NicolasU-N/PeltierController/Deliverables_PeltierPWMControlPCB/Deliverables/Images/6.jpg

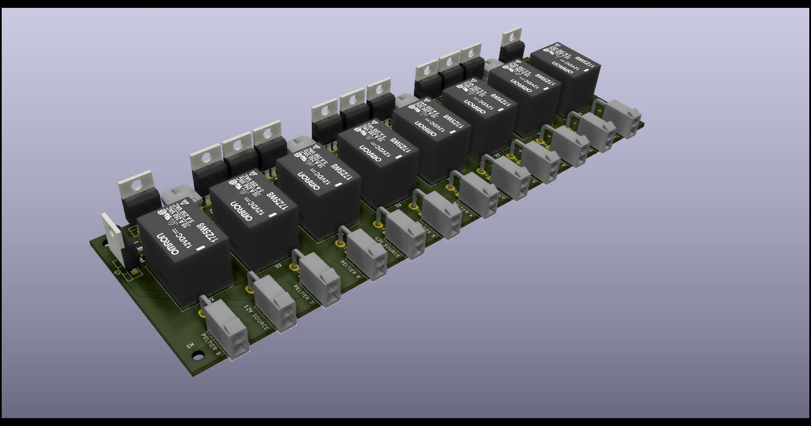
Deliverables_PeltierPWMControlPCB/Deliverables/Images/6.jpg
