NicolasU-N/PeltierController/Deliverables_ControllerPCB/Deliverables/Images/6.jpg

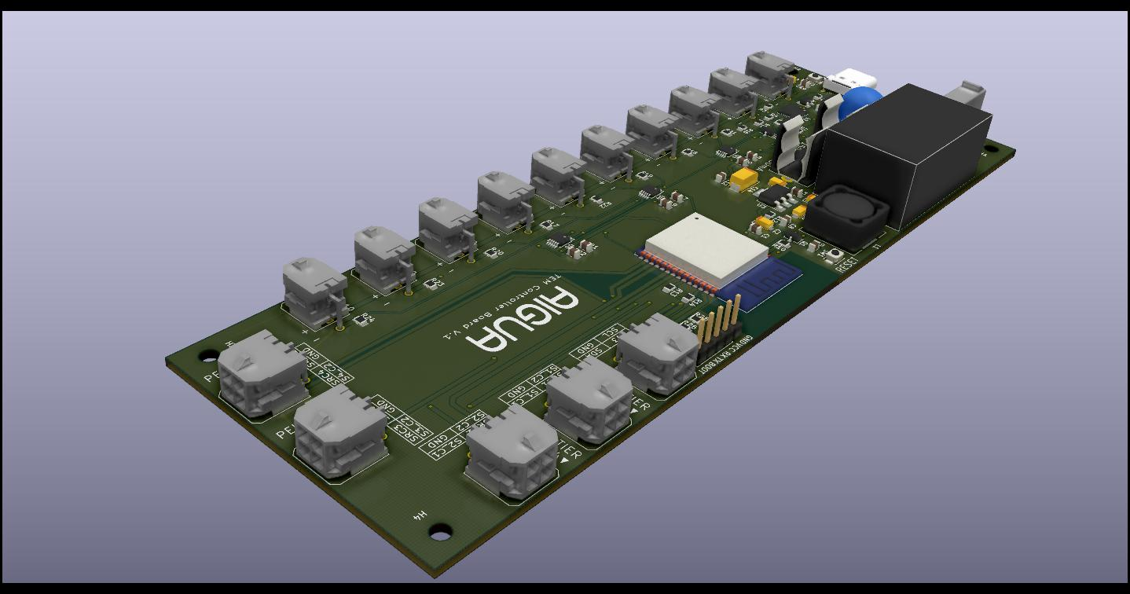
Deliverables_ControllerPCB/Deliverables/Images/6.jpg
