NicolasU-N/PeltierController/Deliverables_ControllerPCB/Deliverables/Images/1.jpg

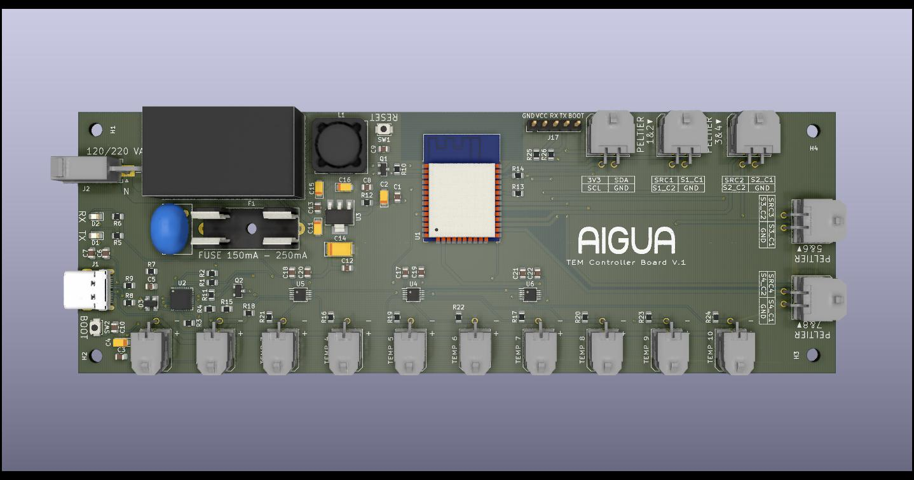
Deliverables_ControllerPCB/Deliverables/Images/1.jpg
