NicolasU-N/PeltierController/Deliverables_ControllerPCB/Deliverables/Images/2.jpg

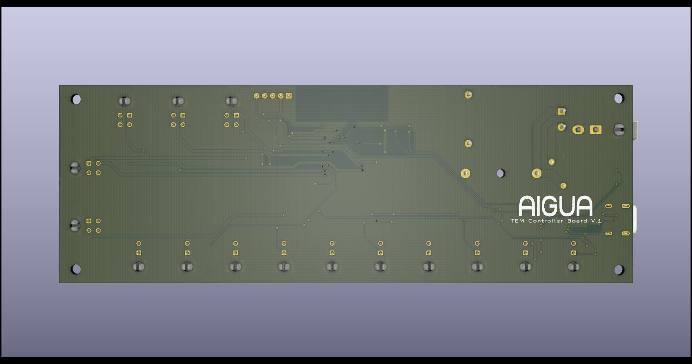
Deliverables_ControllerPCB/Deliverables/Images/2.jpg
