NicolasU-N/PeltierController/Deliverables_ControllerPCB/Deliverables/Images/3.jpg

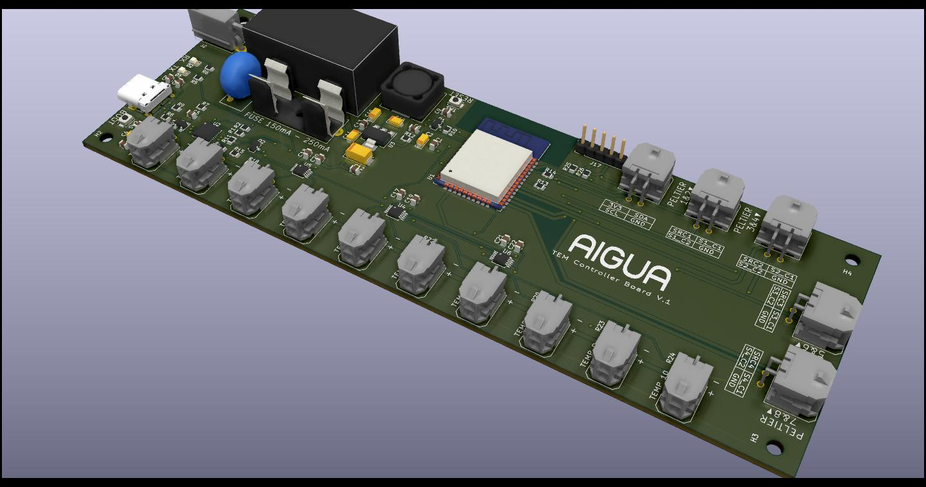
Deliverables_ControllerPCB/Deliverables/Images/3.jpg
