NicolasU-N/PeltierController/Deliverables_ControllerPCB/Deliverables/Images/4.jpg

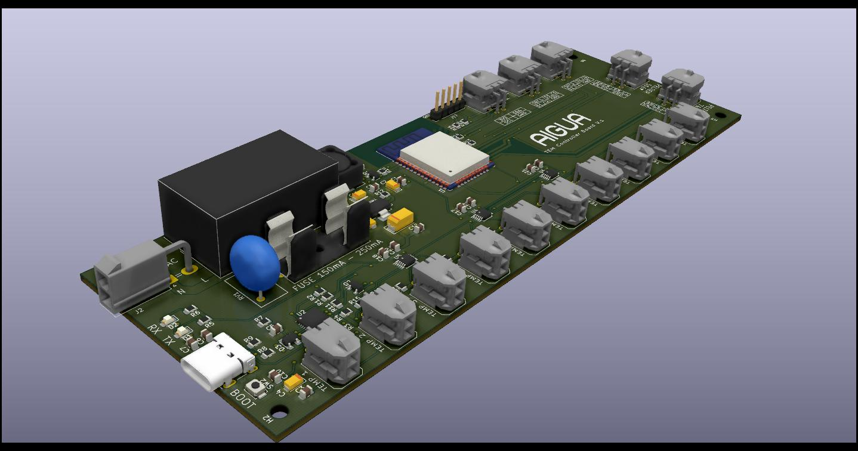
Deliverables_ControllerPCB/Deliverables/Images/4.jpg
