NicolasU-N/PeltierController/Deliverables_ControllerPCB/Deliverables/Images/5.jpg

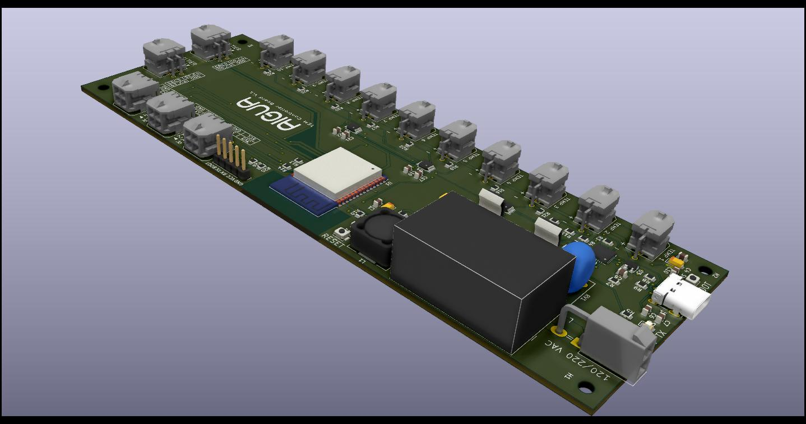
Deliverables_ControllerPCB/Deliverables/Images/5.jpg
