NicolasU-N/PeltierController/Deliverables_PeltierPWMControlPCB/Deliverables/Images/1.jpg

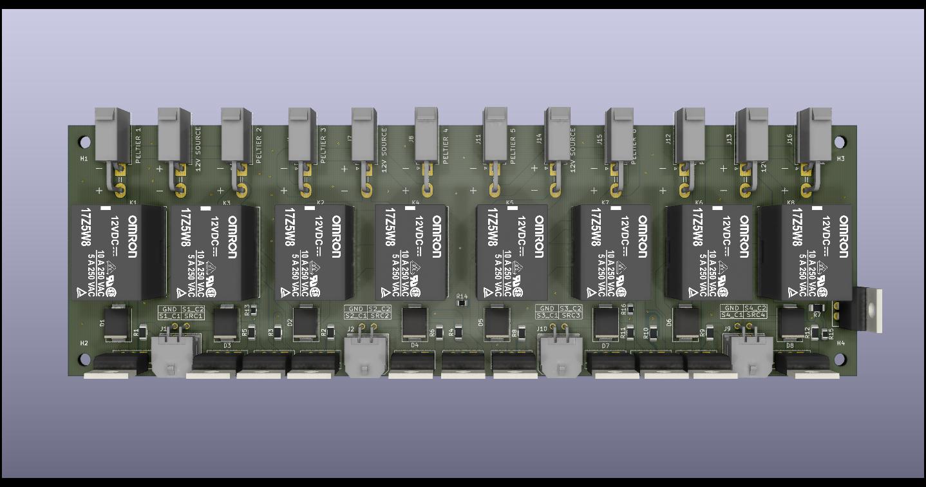
Deliverables_PeltierPWMControlPCB/Deliverables/Images/1.jpg
