NicolasU-N/PeltierController/Deliverables_PeltierPWMControlPCB/Deliverables/Images/2.jpg

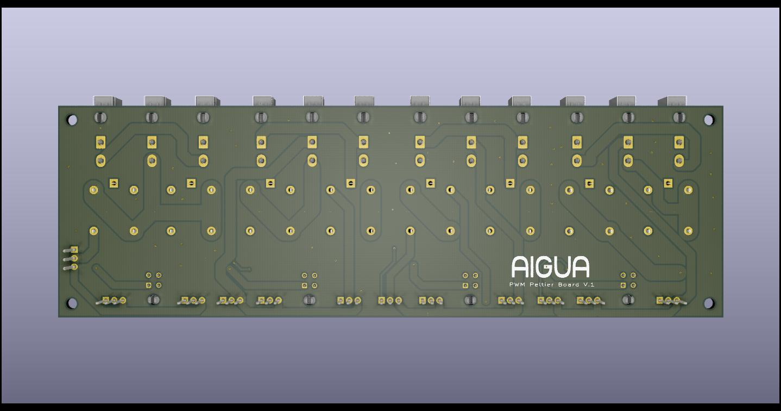
Deliverables_PeltierPWMControlPCB/Deliverables/Images/2.jpg
