NicolasU-N/PeltierController/Deliverables_PeltierPWMControlPCB/Deliverables/Images/3.jpg

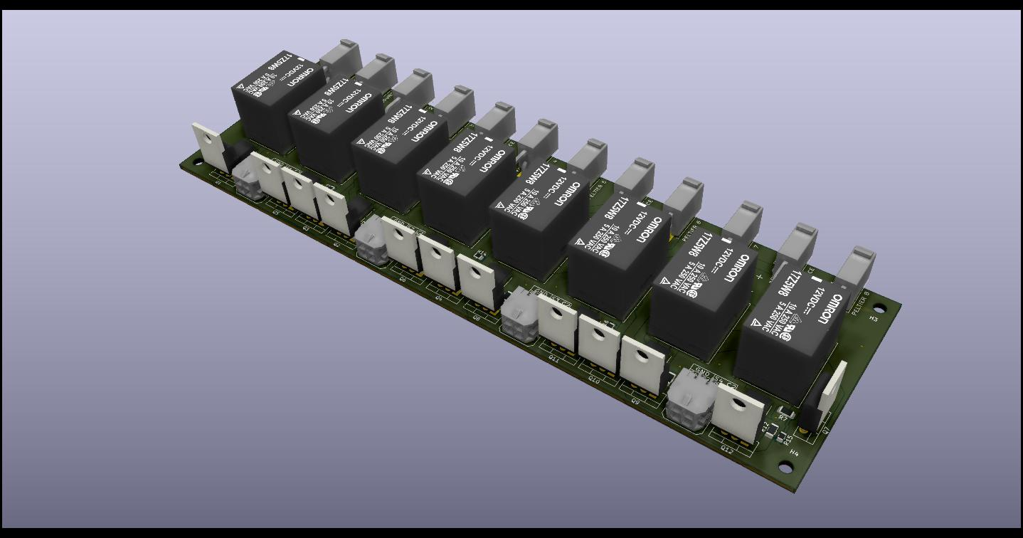
Deliverables_PeltierPWMControlPCB/Deliverables/Images/3.jpg
