NicolasU-N/PeltierController/Deliverables_PeltierPWMControlPCB/Deliverables/Images/5.jpg

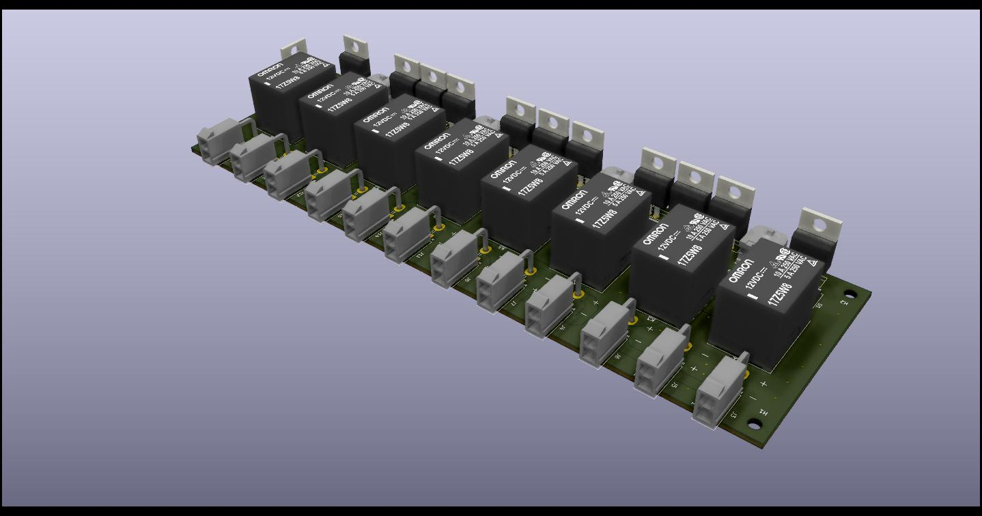
Deliverables_PeltierPWMControlPCB/Deliverables/Images/5.jpg
