NicolasU-N/PeltierController/Deliverables_SensorPCB/Deliverables/Images/1.jpg

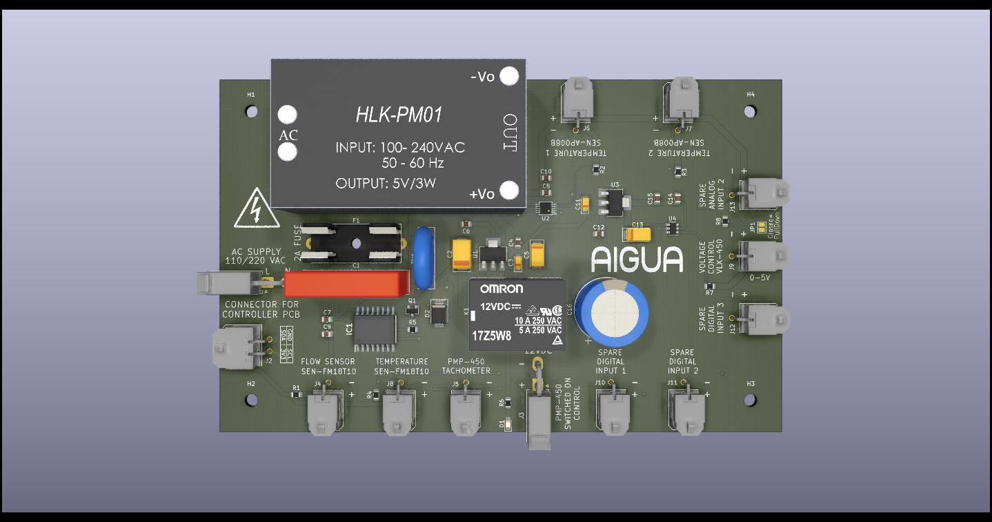
Deliverables_SensorPCB/Deliverables/Images/1.jpg
