NicolasU-N/PeltierController/Deliverables_SensorPCB/Deliverables/Images/2.jpg

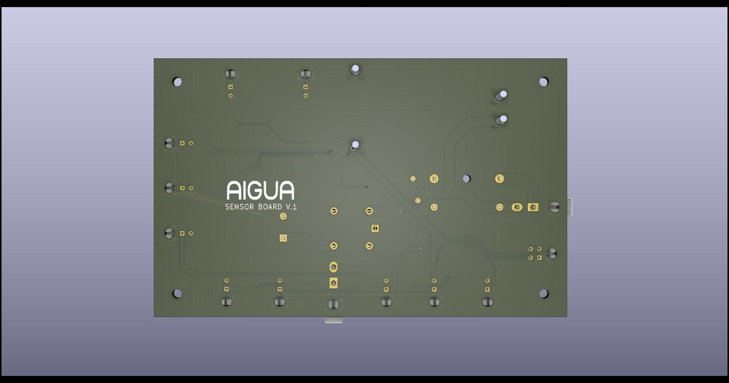
Deliverables_SensorPCB/Deliverables/Images/2.jpg
