NicolasU-N/PeltierController/Deliverables_SensorPCB/Deliverables/Images/3.jpg

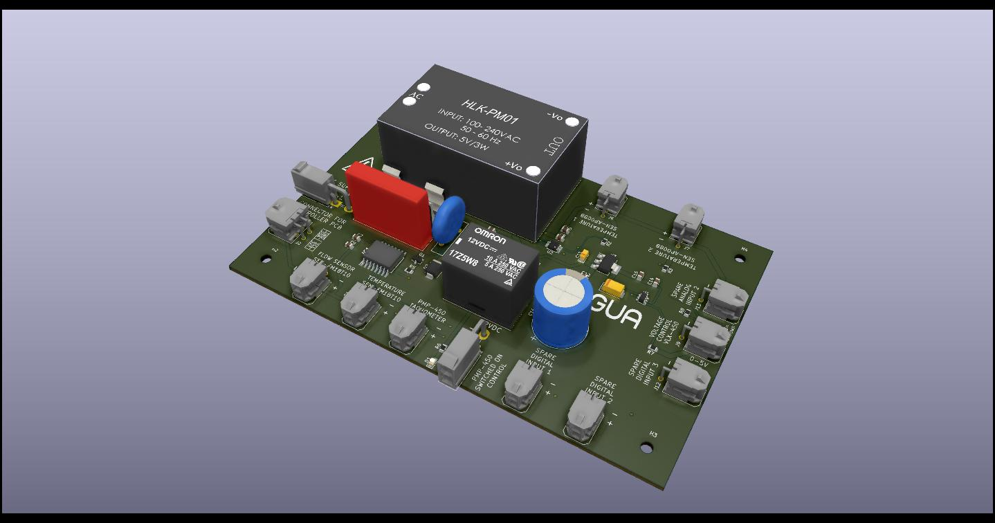
Deliverables_SensorPCB/Deliverables/Images/3.jpg
