NicolasU-N/PeltierController/Deliverables_SensorPCB/Deliverables/Images/4.jpg

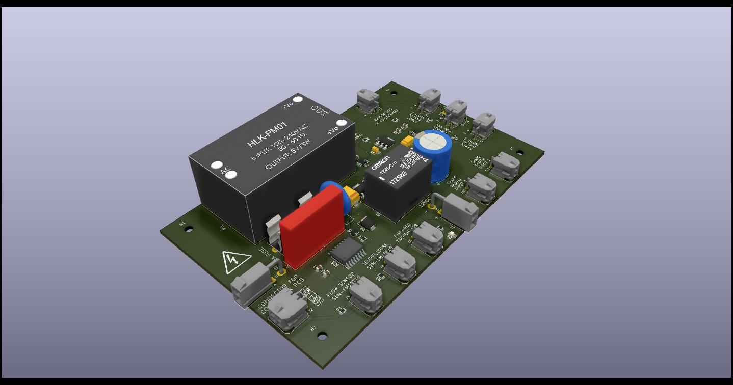
Deliverables_SensorPCB/Deliverables/Images/4.jpg
