NicolasU-N/PeltierController/Deliverables_SensorPCB/Deliverables/Images/5.jpg

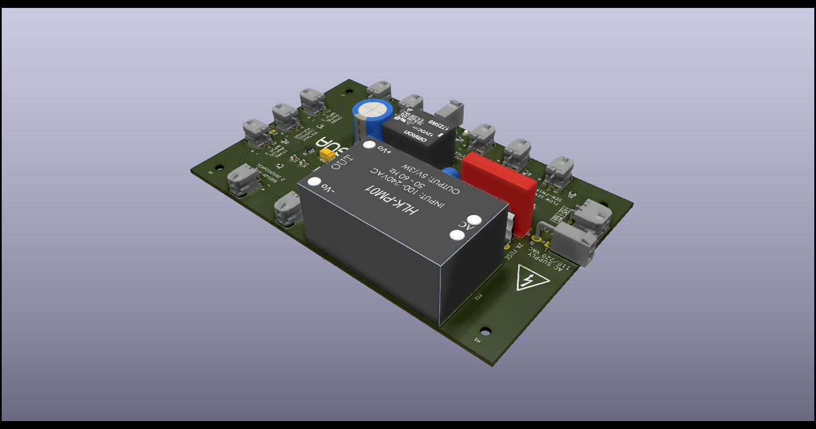
Deliverables_SensorPCB/Deliverables/Images/5.jpg
