NicolasU-N/PeltierController/Deliverables_SensorPCB/Deliverables/Images/6.jpg

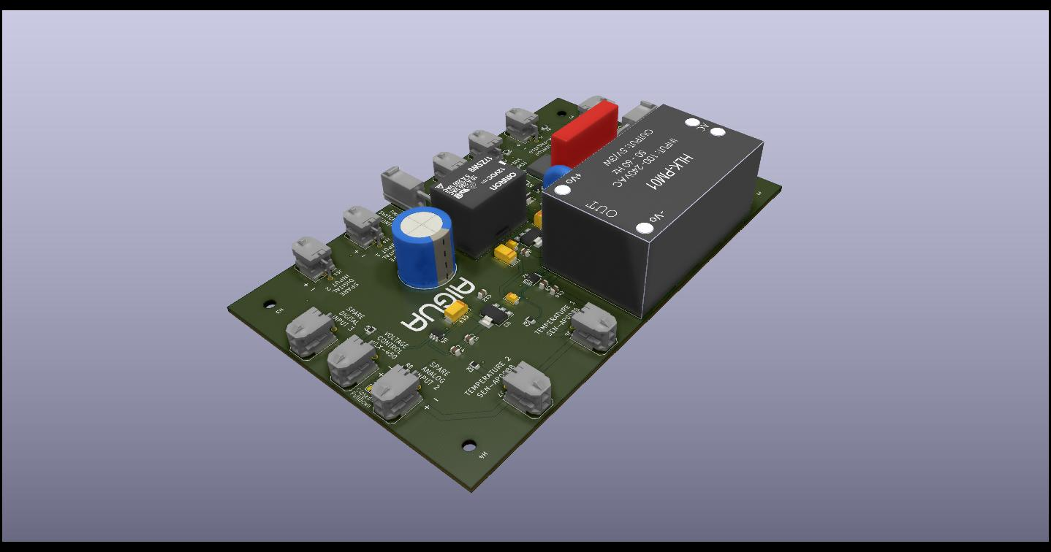
Deliverables_SensorPCB/Deliverables/Images/6.jpg
