NicolasU-N/PeltierController/Deliverables_SensorPCB/Deliverables/Images/7.jpg

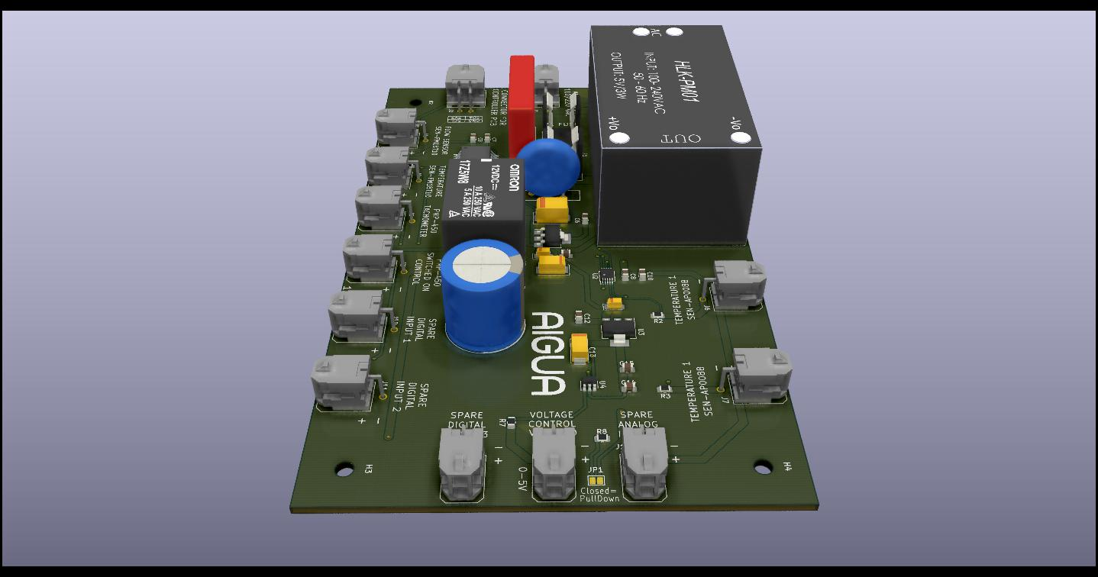
Deliverables_SensorPCB/Deliverables/Images/7.jpg
