NicolasU-N/PeltierController/Deliverables_SensorPCB/Deliverables/Images/8.jpg

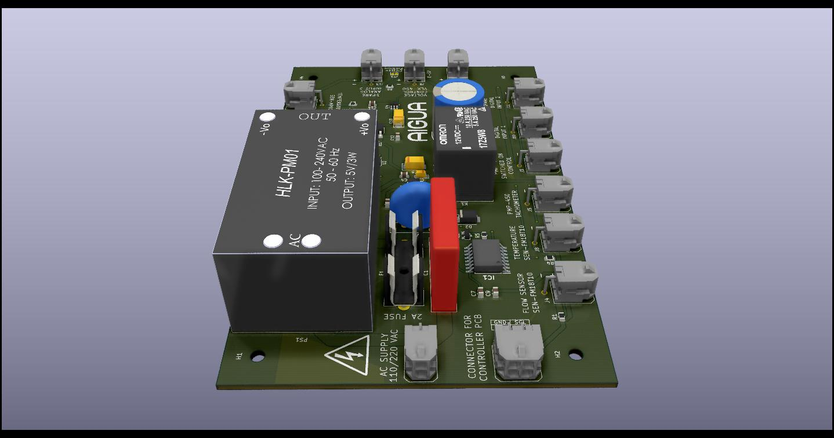
Deliverables_SensorPCB/Deliverables/Images/8.jpg
