NicolasU-N/PeltierController/Firmware/FlowChart/FirmwarePeltier.png

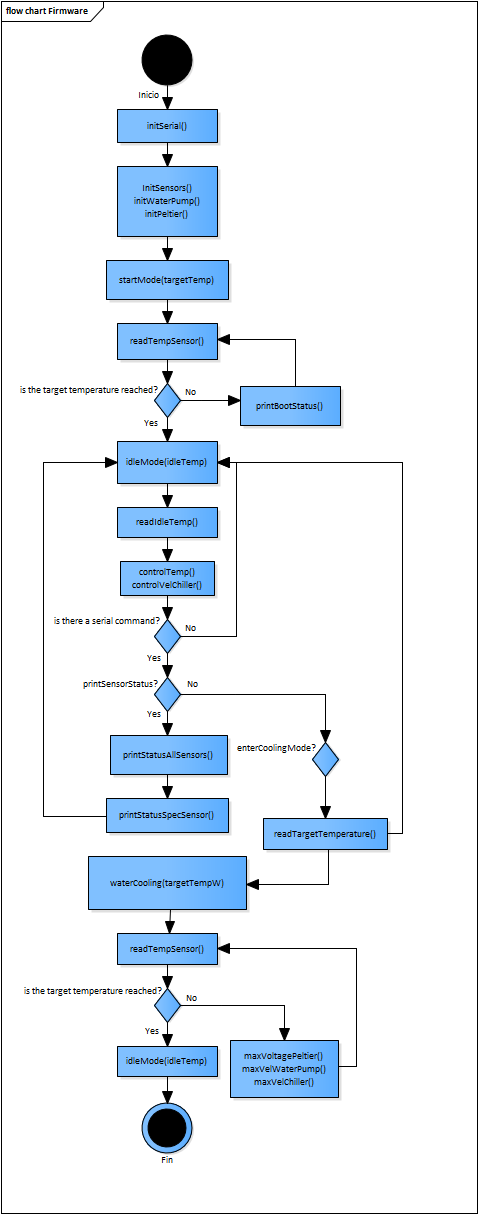
Firmware/FlowChart/FirmwarePeltier.png
