NicolasU-N/PeltierController/Deliverables_ControllerPCB/Deliverables/BOM/BOM.xlsx

Reference | Value | Footprint | Datasheet | Cost | Mfg PN | Vendor Link | Vendor PN | Qty | Rev
C1, C3, C6, C8-C10, C12, C13, C17-C22 | 0.1uF | C_0805_2012Metric | https://www.mouser.com/datasheet/2/40/X7RDielectric-777024.pdf | 0.10 | 08055C104KAT2A | https://www.mouser.com/ProductDetail/AVX/08055C104KAT2A | 581-08055C104K | 14 | OK | 1.40
C2, C4, C15, C16 | 4.7uF/16V | CP_EIA-3216-10_Kemet-I | https://www.mouser.com/datasheet/2/212/1/KEM_T2052_T495_AUTO-1104467.pdf | 1.82 | T495A475K016ATA2K0 | https://www.mouser.com/ProductDetail/KEMET/T495A475K016ATA2K0?qs=ds50AKTGxA%252B3hwRn1pX5qw%3D%3D | 80-T495A475K16ATA2K0 | 4 | OK | 7.28
C5 | 4.7nF | C_0805_2012Metric | https://www.mouser.com/datasheet/2/445/885012207090-1727858.pdf | 0.10 | 885012207090 | https://www.mouser.com/ProductDetail/Wurth-Elektronik/885012207090 | 710-885012207090 | 1 | OK | 0.10
C7 | 10uF | C_0805_2012Metric | https://www.mouser.com/datasheet/2/585/MLCC-1837944.pdf | 0.11 | CL21A106KQFNNNG | https://www.mouser.com/ProductDetail/Samsung-Electro-Mechanics/CL21A106KQFNNNG | 187-CL21A106KQFNNNG | 1 | OK | 0.11
C11 | 10uF/16V | CP_EIA-3216-10_Kemet-I | https://www.mouser.com/datasheet/2/212/1/KEM_T2005_T491-1093550.pdf | 0.39 | T491A106M016AT | https://www.mouser.com/ProductDetail/KEMET/T491A106M016AT?qs=VCf6WUQjPgGgZRSYsrkBHA%3D%3D | 80-T491A106M016 | 1 | OK | 0.39
C14 | 22uF/16V | CP_EIA-6032-28_Kemet-C | https://www.mouser.com/datasheet/2/212/1/KEM_T2005_T491-1093550.pdf | 0.71 | T491C226K016AT7280 | https://www.mouser.com/ProductDetail/KEMET/T491C226K016AT7280?qs=DvBfZ8bnu98MkRBG5q6PCw%3D%3D | 80-T491C226K16AT7280 | 1 | OK | 0.71
D1, D2 | LED_ALT | LED_0805_2012Metric_Castellated | https://www.mouser.com/datasheet/2/445/150080BS75000-1715853.pdf | 0.18 | 150080BS75000 | https://www.mouser.com/ProductDetail/Wurth-Elektronik/150080BS75000?qs=2kOmHSv6VfT2tBo3UPVqAQ%3D%3D | 710-150080BS75000 | 2 | OK | 0.36
D3 | PRTR5V0U2X | SOT-143 | https://www.mouser.com/datasheet/2/916/PRTR5V0U2X-1320589.pdf | 0.51 | PRTR5V0U2X,215 | https://www.mouser.com/ProductDetail/Nexperia/PRTR5V0U2X215 | 771-PRTR5V0U2X-T/R | 1 | OK | 0.51
F1 | 240V/2A | Fuseholder_Cylinder-5x20mm_Schurter_0031_8201_Horizontal_Open | https://www.mouser.com/datasheet/2/358/typ_OGN-14523.pdf | 0.80 | 318201 | https://www.mouser.com/ProductDetail/Schurter/00318201?qs=A0AD9A9uYPZ%2F5Y96FqMyAQ%3D%3D | 693-0031.8201 | 1 | OK | 0.80
J1 | USB_C_Receptacle | MOLEX_105450-0101 | https://www.mouser.com/datasheet/2/276/1/1054500101_IO_CONNECTORS-1373915.pdf | 2.19 | 105450-0101 | https://www.mouser.com/ProductDetail/Molex/105450-0101 | 538-105450-0101 | 1 | OK | 2.19
J2 | Screw_Terminal_01x02 | Molex_Mini-Fit_Jr_5569-02A2_2x01_P4.20mm_Horizontal | https://www.mouser.com/datasheet/2/276/0039301020_PCB_HEADERS-140213.pdf | 0.51 | 39-30-1020 | https://www.mouser.com/ProductDetail/Molex/39-30-1020/?qs=tRPrwvvr%2Fuj45jNVCpHEJA%3D%3D | 538-39-30-1020 | 1 | OK | 0.51
J3-J6, J18 | Conn_01x04 | Molex_Micro-Fit_3.0_43045-0400_2x02_P3.00mm_Horizontal | https://www.mouser.com/datasheet/2/276/0430450400_PCB_HEADERS-168191.pdf | 1.32 | 43045-0400 | https://www.mouser.com/ProductDetail/Molex/43045-0400/ | 538-43045-0400 | 5 | OK | 6.60
J7-J16 | Conn_01x02 | Molex_Micro-Fit_3.0_43045-0200_2x01_P3.00mm_Horizontal | https://www.mouser.com/datasheet/2/276/0430450200_PCB_HEADERS-145770.pdf | 0.79 | 43045-0200 | https://www.mouser.com/ProductDetail/Molex/43045-0200/ | 538-43045-0200 | 10 | OK | 7.90
J17 | Conn_01x05 | PinHeader_1x05_P2.54mm_Vertical | https://www.amphenol-icc.com/media/wysiwyg/files/documentation/datasheet/boardwiretoboard/bwb_bergstik.pdf | 0.18 | 54101-T06-05 | https://www.mouser.com/ProductDetail/Amphenol-FCI/54101-T06-05/?qs=Hwu%252BwqWVL7Ext75Zyu6Cbw%3D%3D | 649-54101-T06-05 | 1 | OK | 0.18
L1 | 100uH | L_12x12mm_H8mm | https://www.mouser.com/datasheet/2/54/SRR1280A-1391399.pdf | 1.00 | SRR1280A-101M | https://www.mouser.com/ProductDetail/Bourns/SRR1280A-101M?qs=jtImr9hqsuH1GFDBNpoVVQ%3D%3D | 652-SRR1280A-101M | 1 | OK | 1.00
PS1 | HLK-PM01 | Converter_ACDC_HiLink_HLK-PMxx | http://www.hlktech.net/product_detail.php?ProId=54 | 2.10 | HLK-PM01 | http://www.hlktech.net/product_detail.php?ProId=54 | HLK-PM01 | 1 | OK | 2.10
Q1, Q2 | MMBT3904 | SOT-23 | https://www.mouser.com/datasheet/2/916/MMBT3904-1599187.pdf | 0.10 | MMBT3904,215 | https://www.mouser.com/ProductDetail/Nexperia/MMBT3904215?qs=LOCUfHb8d9s%2FW6hzAJGDbw%3D%3D | 771-MMBT3904T/R | 2 | OK | 0.20
R1, R2, R10, R11, R25, R26 | 560 | R_0805_2012Metric | https://www.mouser.com/datasheet/2/315/AOA0000C304-1149620.pdf | 0.10 | ERJ-6ENF5600V | https://www.mouser.com/ProductDetail/Panasonic/ERJ-6ENF5600V/?qs=50QC8w71jAtIdggp09mubg%3D%3D | 667-ERJ-6ENF5600V | 6 | OK | 0.60
R3, R12, R15-R24 | 10K | R_0805_2012Metric | https://www.mouser.com/datasheet/2/427/crcwce3-1762584.pdf | 0.10 | CRCW080510K0FKEAC | https://www.mouser.com/ProductDetail/Vishay-Dale/CRCW080510K0FKEAC?qs=E3Y5ESvWgWORadmUijPtxQ%3D%3D | 71-CRCW080510K0FKEAC | 12 | OK | 1.20
R4 | 22.1K | R_0805_2012Metric | https://www.mouser.com/datasheet/2/315/AOA0000C304-1149620.pdf | 0.10 | ERJ-6ENF2212V | https://www.mouser.com/ProductDetail/Panasonic/ERJ-6ENF2212V?qs=4WZYzuGhm5qQdbFPuaZqLQ%3D%3D | 667-ERJ-6ENF2212V | 1 | OK | 0.10
R5, R6 | 1K | R_0805_2012Metric | https://www.mouser.com/datasheet/2/427/crcwce3-1762584.pdf | 0.10 | CRCW08051K00FKEAC | https://www.mouser.com/ProductDetail/Vishay-Dale/CRCW08051K00FKEAC?qs=CZ6xfwOSLTXmQIgaYvN%2FBA%3D%3D | 71-CRCW08051K00FKEAC | 2 | OK | 0.20
R7 | 1M | R_0805_2012Metric | https://www.mouser.com/datasheet/2/427/crcwce3-1762584.pdf | 0.10 | CRCW08051M00FKEAC | https://www.mouser.com/ProductDetail/Vishay-Dale/CRCW08051M00FKEAC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 | 71-CRCW08051M00FKEAC | 1 | OK | 0.10
R8, R9 | 5.1K | R_0805_2012Metric | https://www.mouser.com/datasheet/2/427/dcrcwe3-1762152.pdf | 0.10 | CRCW08055K10JNEB | https://www.mouser.com/ProductDetail/Vishay-Dale/CRCW08055K10JNEB | CRCW08055K10JNEB | 2 | OK | 0.20
R13, R14 | 2.4K | R_0805_2012Metric | https://www.mouser.com/datasheet/2/315/AOA0000C301-1488782.pdf | 0.10 | ERJ-6GEYJ242V | https://www.mouser.com/ProductDetail/Panasonic/ERJ-6GEYJ242V?qs=8%252BG0TiN%2FgVrLEtNaFaLOwA%3D%3D | 667-ERJ-6GEYJ242V | 2 | OK | 0.20
RV1 | 275V | RV_Disc_D12mm_W7.1mm_P7.5mm | https://www.mouser.com/datasheet/2/54/mov10d-777448.pdf | 0.46 | MOV-10D511K | https://www.mouser.com/ProductDetail/Bourns/MOV-10D511K/?qs=lgttKnAd%252B2BmTxrbFsFYog%3D%3D | 652-MOV-10D511K | 1 | OK | 0.46
SW1, SW2 | SW_Push | SW_SPST_B3U-1000P | https://www.mouser.com/datasheet/2/307/en-b3u-3615.pdf | 0.92 | B3U-1000P | https://www.mouser.com/ProductDetail/Omron-Electronics/B3U-1000P?qs=AO7BQMcsEu4ip80xyf2FwA%3D%3D | 653-B3U-1000P | 2 | OK | 1.84
U1 | ESP32-WROOM-32 | ESP32-WROOM-32 | https://www.mouser.com/datasheet/2/891/esp32-wroom-32e_esp32-wroom-32ue_datasheet_en-1855879.pdf | 2.50 | ESP32-WROOM-32E(M113EH3200PH3Q0) | https://www.mouser.com/ProductDetail/Espressif-Systems/ESP32-WROOM-32EM113EH3200PH3Q0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 | 356-ESP32WRM32E132PH | 1 | OK | 2.50
U2 | CP2102N-A02-GQFN28R | QFN-28-1EP_5x5mm_P0.5mm_EP3.35x3.35mm | https://www.mouser.com/datasheet/2/368/cp2102n_datasheet-1634912.pdf | 1.40 | CP2102N-A02-GQFN28R | https://www.mouser.com/ProductDetail/Silicon-Labs/CP2102N-A02-GQFN28R/?qs=u16ybLDytRag4qKvSH3fTw%3D%3D | 634-CP2102NA02QFN28R | 1 | OK | 1.40
U3 | AZ1117-3.3 | SOT-223-3_TabPin2 | https://www.mouser.com/datasheet/2/115/AZ1117I-1113551.pdf | 0.36 | AZ1117IH-3.3TRG1 | https://www.mouser.com/ProductDetail/Diodes-Incorporated/AZ1117IH-33TRG1?qs=cpo3%2FpBou2jnS4SxLgAVoA%3D%3D | 621-AZ1117IH-3.3TRG1 | 1 | OK | 0.36
U4-U6 | ADS1115IDGS | TSSOP-10_3x3mm_P0.5mm | http://www.ti.com/general/docs/suppproductinfo.tsp?distId=26 | 5.30 | ADS1115IDGSR | https://www.mouser.com/ProductDetail/Texas-Instruments/ADS1115IDGSR | 595-ADS1115IDGSR | 3 | OK | 15.90
 |  |  |  |  |  |  | TOTAL | 83 |  | 57.40
