NicolasU-N/PeltierController/Deliverables_PeltierPWMControlPCB/Deliverables/BOM/BOM.xlsx

Reference | Value | Footprint | Datasheet | Cost | Mfg PN | Vendor Link | Vendor PN | Qty | Rev
D1-D8 | SS34 | D_SMC | https://www.mouser.com/datasheet/2/308/SS39-D-1814961.pdf | 0.46 | SS34 | https://www.mouser.com/ProductDetail/ON-Semiconductor-Fairchild/SS34?qs=2ONuHmP%2FXzb3ub11UdFfdQ%3D%3D | 512-SS34 | 8 | OK | 3.68
J1,J2,J9,J10 | Conn_01x04 | Molex_Micro-Fit_3.0_43045-0400_2x02_P3.00mm_Horizontal | https://www.mouser.com/datasheet/2/276/0430450400_PCB_HEADERS-168191.pdf | 1.32 | 43045-0400 | https://www.mouser.com/ProductDetail/Molex/43045-0400/ | 538-43045-0400 | 4 | OK | 5.28
J3-J8,J11-J16 | Screw_Terminal_01x02 | Molex_Mini-Fit_Jr_5569-02A2_2x01_P4.20mm_Horizontal | https://www.mouser.com/datasheet/2/276/0039301020_PCB_HEADERS-140213.pdf | 0.51 | 39-30-1020 | https://www.mouser.com/ProductDetail/Molex/39-30-1020/?qs=tRPrwvvr%2Fuj45jNVCpHEJA%3D%3D | 538-39-30-1020 | 12 | OK | 6.12
K1-K8 | G5LE-1-DC12 | Relay_SPDT_Omron-G5LE-1 | https://www.mouser.com/datasheet/2/307/en-g5le-1131193.pdf | 1.37 | G5LE-1-DC12 | https://www.mouser.com/ProductDetail/Omron-Electronics/G5LE-1-DC12?qs=Rh%252BaoYk36r4VGdet26ofGg%3D%3D | 653-G5LE-1-DC12 | 8 | OK | 10.96
Q1,Q2,Q5,Q6,Q8,Q9,Q11,Q12 | TIP41C | TO-220-3_Vertical | https://www.mouser.com/datasheet/2/389/tip41c-1852274.pdf | 0.64 | TIP41C | https://www.mouser.com/ProductDetail/STMicroelectronics/TIP41C?qs=ljbEvF4DwOPALsfJVTZHww%3D%3D | 511-TIP41C | 8 | OK | 5.12
Q3,Q4,Q7,Q10 | IRF640N | TO-220-3_Vertical | https://www.mouser.com/datasheet/2/196/irf640npbf-1228260.pdf | 0.91 | IRF640NPBF | https://www.mouser.com/ProductDetail/Infineon-Technologies/IRF640NPBF?qs=9%252BKlkBgLFf3E8kFH1ru13w%3D%3D | 942-IRF640NPBF | 4 | OK | 3.64
R1,R2,R5,R6,R8,R9,R11,R12 | 1K | R_1206_3216Metric | https://www.mouser.com/datasheet/2/427/crcwce3-1762584.pdf | 0.10 | CRCW12061K00FKEBC | https://www.mouser.com/ProductDetail/Vishay-Dale/CRCW12061K00FKEBC?qs=wd5RIQLrsJhV76yckjWUIg%3D%3D | 71-CRCW12061K00FKEBC | 8 | OK | 0.80
R3,R4,R7,R10 | 100 | R_1206_3216Metric | https://www.mouser.com/datasheet/2/427/crcwce3-1762584.pdf | 0.10 | CRCW1206100RFKEAC | https://www.mouser.com/ProductDetail/Vishay-Dale/CRCW1206100RFKEAC?qs=E3Y5ESvWgWNFW15dUTyIJA%3D%3D | 71-CRCW1206100RFKEAC | 4 | OK | 0.40
R13-R16 | 560K | R_0805_2012Metric | https://www.mouser.com/datasheet/2/54/crxxxxx-1858361.pdf | 0.10 | CR0805-FX-5603ELF | https://www.mouser.com/ProductDetail/Bourns/CR0805-FX-5603ELF/?qs=LA9FZBosJlDODbWra7j3GQ%3D%3D | 652-CR0805FX-5603ELF | 4 | OK | 0.40
 |  |  |  |  |  |  | TOTAL | 60 |  | 36.40
