NicolasU-N/PeltierController/Deliverables_SensorPCB/Deliverables/BOM/BOM.xlsx

Reference | Value | Footprint | Datasheet | Cost | Mfg PN | Vendor Link | Vendor PN | Qty | Rev
C1 | 0.22uF | C_Rect_L26.5mm_W6.0mm_P22.50mm_MKS4 | https://www.mouser.com/datasheet/2/212/1/KEM_F3093_R46_X2_275_110C-1104424.pdf | 0.52 | R46KN322000M1M | https://www.mouser.com/ProductDetail/KEMET/R46KN322000M1M/?qs=06HLYMEcjuURryBNC%2FGUpQ%3D%3D | 80-R46KN322000M1M | 1 | OK | 0.52
C2 | 220uF/16V | CP_EIA-7343-43_Kemet-X | https://www.mouser.com/datasheet/2/212/1/KEM_T2005_T491-1093550.pdf | 1.44 | T491X227K016AT | https://www.mouser.com/ProductDetail/KEMET/T491X227K016AT/?qs=4FCPi%2FOINq3yjCQoEk9XTQ%3D%3D | 80-T491X227K016 | 1 | OK | 1.44
C3, C11 | 10uF/16V | CP_EIA-3216-18_Kemet-A | https://www.mouser.com/datasheet/2/212/1/KEM_T2005_T491-1093550.pdf | 0.39 | T491A106M016AT | https://www.mouser.com/ProductDetail/KEMET/T491A106M016AT/?qs=VCf6WUQjPgGgZRSYsrkBHA%3D%3D | 80-T491A106M016 | 2 | OK | 0.78
C4, C7, C8, C12, C14 | 1uF | C_0805_2012Metric | https://www.mouser.com/datasheet/2/585/MLCC-1837944.pdf | 0.10 | CL21B105KOFNNNG | https://www.mouser.com/ProductDetail/Samsung-Electro-Mechanics/CL21B105KOFNNNG/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 | 187-CL21B105KOFNNNG | 5 | OK | 0.50
C5, C13 | 22uF/16V | CP_EIA-6032-28_Kemet-C | https://www.mouser.com/datasheet/2/212/1/KEM_T2009_T495-1092841.pdf | 0.98 | T495C226K016ATE350 | https://www.mouser.com/ProductDetail/KEMET/T495C226K016ATE350/?qs=Ad%252Bh9aq9FyUFXYOXaaIXXA%3D%3D | 80-T495C226K16ATE350 | 2 | OK | 1.96
C6, C9, C10, C15 | 0.1uF | C_0805_2012Metric | https://www.mouser.com/datasheet/2/40/X7RDielectric-777024.pdf | 0.10 | 08055C104KAT2A | https://www.mouser.com/ProductDetail/AVX/08055C104KAT2A/ | 581-08055C104K | 4 | OK | 0.40
C16 | 6800uF | CP_Radial_D16.0mm_P7.50mm | https://www.mouser.com/datasheet/2/977/e_PK-1601094.pdf | 1.68 | 25PK6800MEFC16X31.5 | https://www.mouser.com/ProductDetail/Rubycon/25PK6800MEFC16X315/?qs=T3oQrply3y8rd0sIOTQqeQ%3D%3D | 232-25PK6800MEFC16X3 | 1 | OK | 1.68
D1 | LED_ALT | LED_0805_2012Metric_Castellated | https://www.mouser.com/datasheet/2/445/150080BS75000-1715853.pdf | 0.18 | 150080BS75000 | https://www.mouser.com/ProductDetail/Wurth-Elektronik/150080BS75000?qs=2kOmHSv6VfT2tBo3UPVqAQ%3D%3D | 710-150080BS75000 | 1 | OK | 0.18
D2 | D | D_SMB | https://www.mouser.com/datasheet/2/80/SP-JB017_SS34B-HF_Thru._SS320B-HF_RevB-1847021.pdf | 0.32 | SS34B-HF | https://www.mouser.com/ProductDetail/Comchip-Technology/SS34B-HF/?qs=vmHwEFxEFR9G1M%252BcUPG%2FxQ%3D%3D | 750-SS34B-HF | 1 | OK | 0.32
F1 | 250Vac/2A | Fuseholder_Cylinder-5x20mm_Schurter_0031_8201_Horizontal_Open | https://www.mouser.com/datasheet/2/358/typ_OGN-14523.pdf | 0.80 | 318201 | https://www.mouser.com/ProductDetail/Schurter/00318201?qs=A0AD9A9uYPZ%2F5Y96FqMyAQ%3D%3D | 693-0031.8201 | 1 | OK | 0.80
IC1 | PCF8574ADWR | PCF8574ADWR | http://www.ti.com/general/docs/suppproductinfo.tsp?distId=26 | 1.28 | PCF8574ADWR | https://www.mouser.com/ProductDetail/Texas-Instruments/PCF8574ADWR/?qs=0OT4q4QBUTLg2X43EU%252BZPg%3D%3D | 595-PCF8574ADWR | 1 | OK | 1.28
J1, J3 | Conn_01x02 | Molex_Mini-Fit_Jr_5569-02A2_2x01_P4.20mm_Horizontal | https://www.mouser.com/datasheet/2/276/0039301020_PCB_HEADERS-140213.pdf | 0.51 | 39-30-1020 | https://www.mouser.com/ProductDetail/Molex/39-30-1020/?qs=tRPrwvvr%2Fuj45jNVCpHEJA%3D%3D | 538-39-30-1020 | 2 | OK | 1.02
J2 | Conn_01x04 | Molex_Micro-Fit_3.0_43045-0400_2x02_P3.00mm_Horizontal | https://www.mouser.com/datasheet/2/276/0430450400_PCB_HEADERS-168191.pdf | 1.32 | 43045-0400 | https://www.mouser.com/ProductDetail/Molex/43045-0400/ | 538-43045-0400 | 1 | OK | 1.32
J4-J13 | Conn_01x02 | Molex_Micro-Fit_3.0_43045-0200_2x01_P3.00mm_Horizontal | https://www.mouser.com/datasheet/2/276/0430450200_PCB_HEADERS-145770.pdf | 0.79 | 43045-0200 | https://www.mouser.com/ProductDetail/Molex/43045-0200/ | 538-43045-0200 | 10 | OK | 7.90
K1 | G5LE-1-DC5.0 | Relay_SPDT_Omron-G5LE-1 | http://www.omron.com/ecb/products/pdf/en-g5le.pdf | 1.49 | G5LE-1-DC5 | https://www.mouser.com/ProductDetail/Omron-Electronics/G5LE-1-DC5/ | 653-G5LE-1-DC5 | 1 | OK | 1.49
PS1 | HLK-20M12 | HLK-20M12 | https://datasheet.lcsc.com/szlcsc/1912111437_HI-LINK-HLK-20M12_C465408.pdf | 4.37 | HLK-20M12 | https://lcsc.com/product-detail/Power-Modules_HI-LINK-HLK-20M12_C465408.html | C465408 | 1 | OK | 4.37
Q1 | MMBT3906 | SOT-23 | https://www.mouser.com/datasheet/2/345/mmbt3906-1396152.pdf | 0.10 | MMBT3906 | https://www.mouser.com/ProductDetail/Rectron/MMBT3906/?qs=w%2Fv1CP2dgqpljHf4BP5MNw%3D%3D | 583-MMBT3906 | 1 | OK | 0.10
R1-R4, R8 | 10K | R_0805_2012Metric | https://www.mouser.com/datasheet/2/427/crcwce3-1762584.pdf | 0.10 | CRCW080510K0FKEAC | https://www.mouser.com/ProductDetail/Vishay-Dale/CRCW080510K0FKEAC?qs=E3Y5ESvWgWORadmUijPtxQ%3D%3D | 71-CRCW080510K0FKEAC | 5 | OK | 0.50
R5 | 1K | R_0805_2012Metric | https://www.mouser.com/datasheet/2/427/crcwce3-1762584.pdf | 0.10 | CRCW080510K0FKEAC | https://www.mouser.com/ProductDetail/Vishay-Dale/CRCW080510K0FKEAC?qs=E3Y5ESvWgWORadmUijPtxQ%3D%3D | 71-CRCW080510K0FKEAC | 1 | OK | 0.10
R6, R7 | 330 | R_0805_2012Metric | https://www.mouser.com/datasheet/2/427/crcwce3-1762584.pdf | 0.10 | CRCW0805330RJNEAC | https://www.mouser.com/ProductDetail/Vishay-Dale/CRCW0805330RJNEAC/?qs=E3Y5ESvWgWMUQcrnxBr%252BUg%3D%3D | 71-CRCW0805330RJNEAC | 2 | OK | 0.20
RV1 | MOV-14D561KTR | RV_Disc_D15.5mm_W4.2mm_P7.5mm | https://www.mouser.com/datasheet/2/54/mov14d-777765.pdf | 0.46 | MOV-14D561KTR | https://www.mouser.com/ProductDetail/Bourns/MOV-14D561KTR/ | 652-MOV-14D561KTR | 1 | OK | 0.46
U1 | AZ1117-3.3 | SOT-223-3_TabPin2 | https://www.mouser.com/datasheet/2/115/AZ1117I-1113551.pdf | 0.36 | AZ1117IH-3.3TRG1 | https://www.mouser.com/ProductDetail/Diodes-Incorporated/AZ1117IH-33TRG1?qs=cpo3%2FpBou2jnS4SxLgAVoA%3D%3D | 621-AZ1117IH-3.3TRG1 | 1 | OK | 0.36
U2 | ADS1115IDGS | TSSOP-10_3x3mm_P0.5mm | http://www.ti.com/general/docs/suppproductinfo.tsp?distId=26 | 5.31 | ADS1115IDGSR | https://www.mouser.com/ProductDetail/Texas-Instruments/ADS1115IDGSR | 595-ADS1115IDGSR | 1 | OK | 5.31
U3 | AZ1117-5.0 | SOT-223-3_TabPin2 | https://www.mouser.com/datasheet/2/115/AZ1117I-1113551.pdf | 0.36 | AZ1117IH-5.0TRG1 | https://www.mouser.com/ProductDetail/Diodes-Incorporated/AZ1117IH-50TRG1/?qs=cpo3%2FpBou2jpUVbxjr50ag%3D%3D | 621-AZ1117IH-5.0TRG1 | 1 | OK | 0.36
U4 | DAC081C081CIMK | SOT-23-6 | http://www.ti.com/general/docs/suppproductinfo.tsp?distId=26 | 1.45 | DAC081C081CIMK/NOPB | https://www.mouser.com/ProductDetail/Texas-Instruments/DAC081C081CIMK-NOPB/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 | 926-DA081C081CIMKNPB | 1 | OK | 1.45
 |  |  |  |  |  |  | TOTAL | 49 |  | 34.80
