NicolasU-N/PeltierController/Deliverables_ControllerPCB/Deliverables/Schematic.pdf

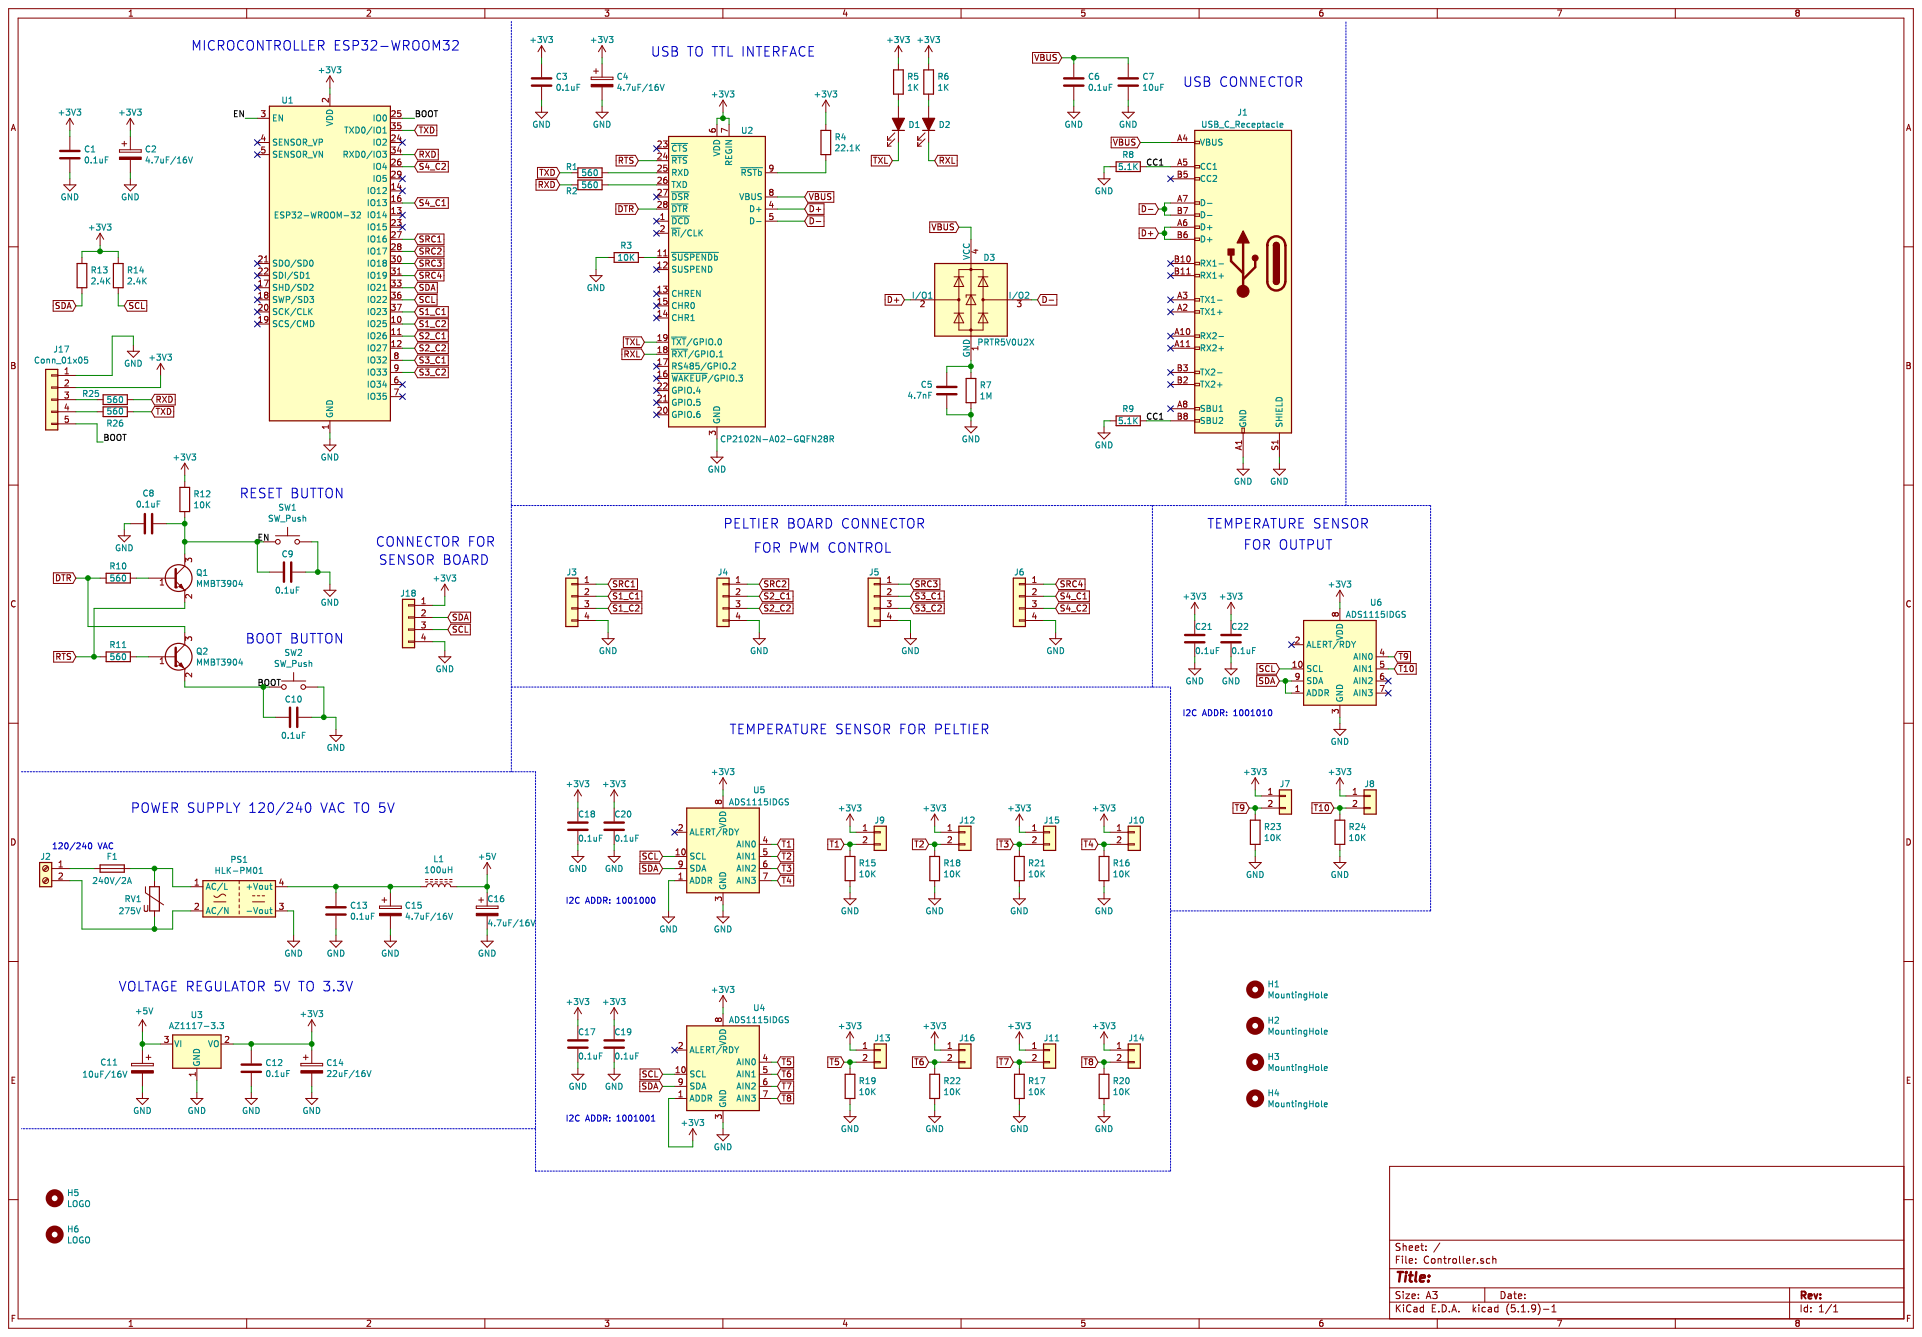
[picture p21: page 1]
