NicolasU-N/PeltierController/Deliverables_PeltierPWMControlPCB/Deliverables/Schematic.pdf

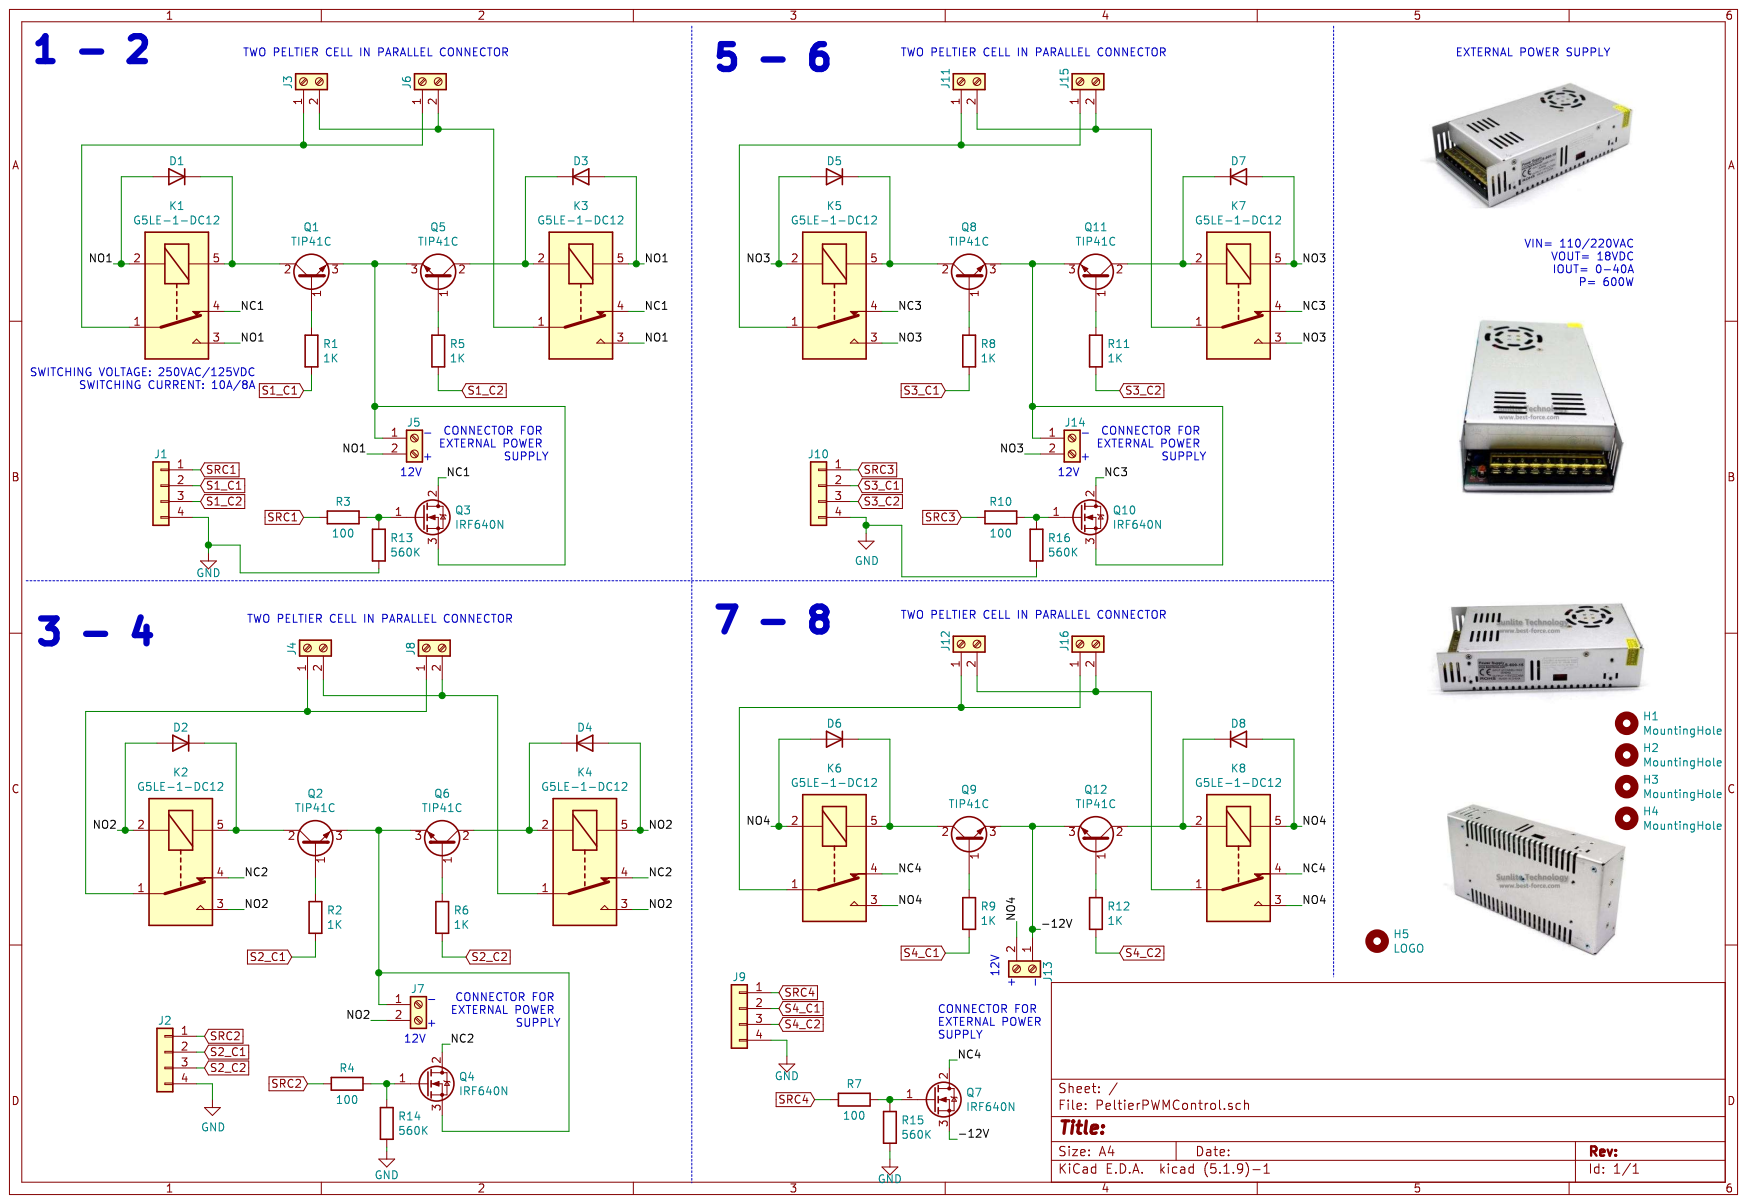
[picture p22: page 1]
