NicolasU-N/PeltierController/Deliverables_SensorPCB/Deliverables/Schematic.pdf

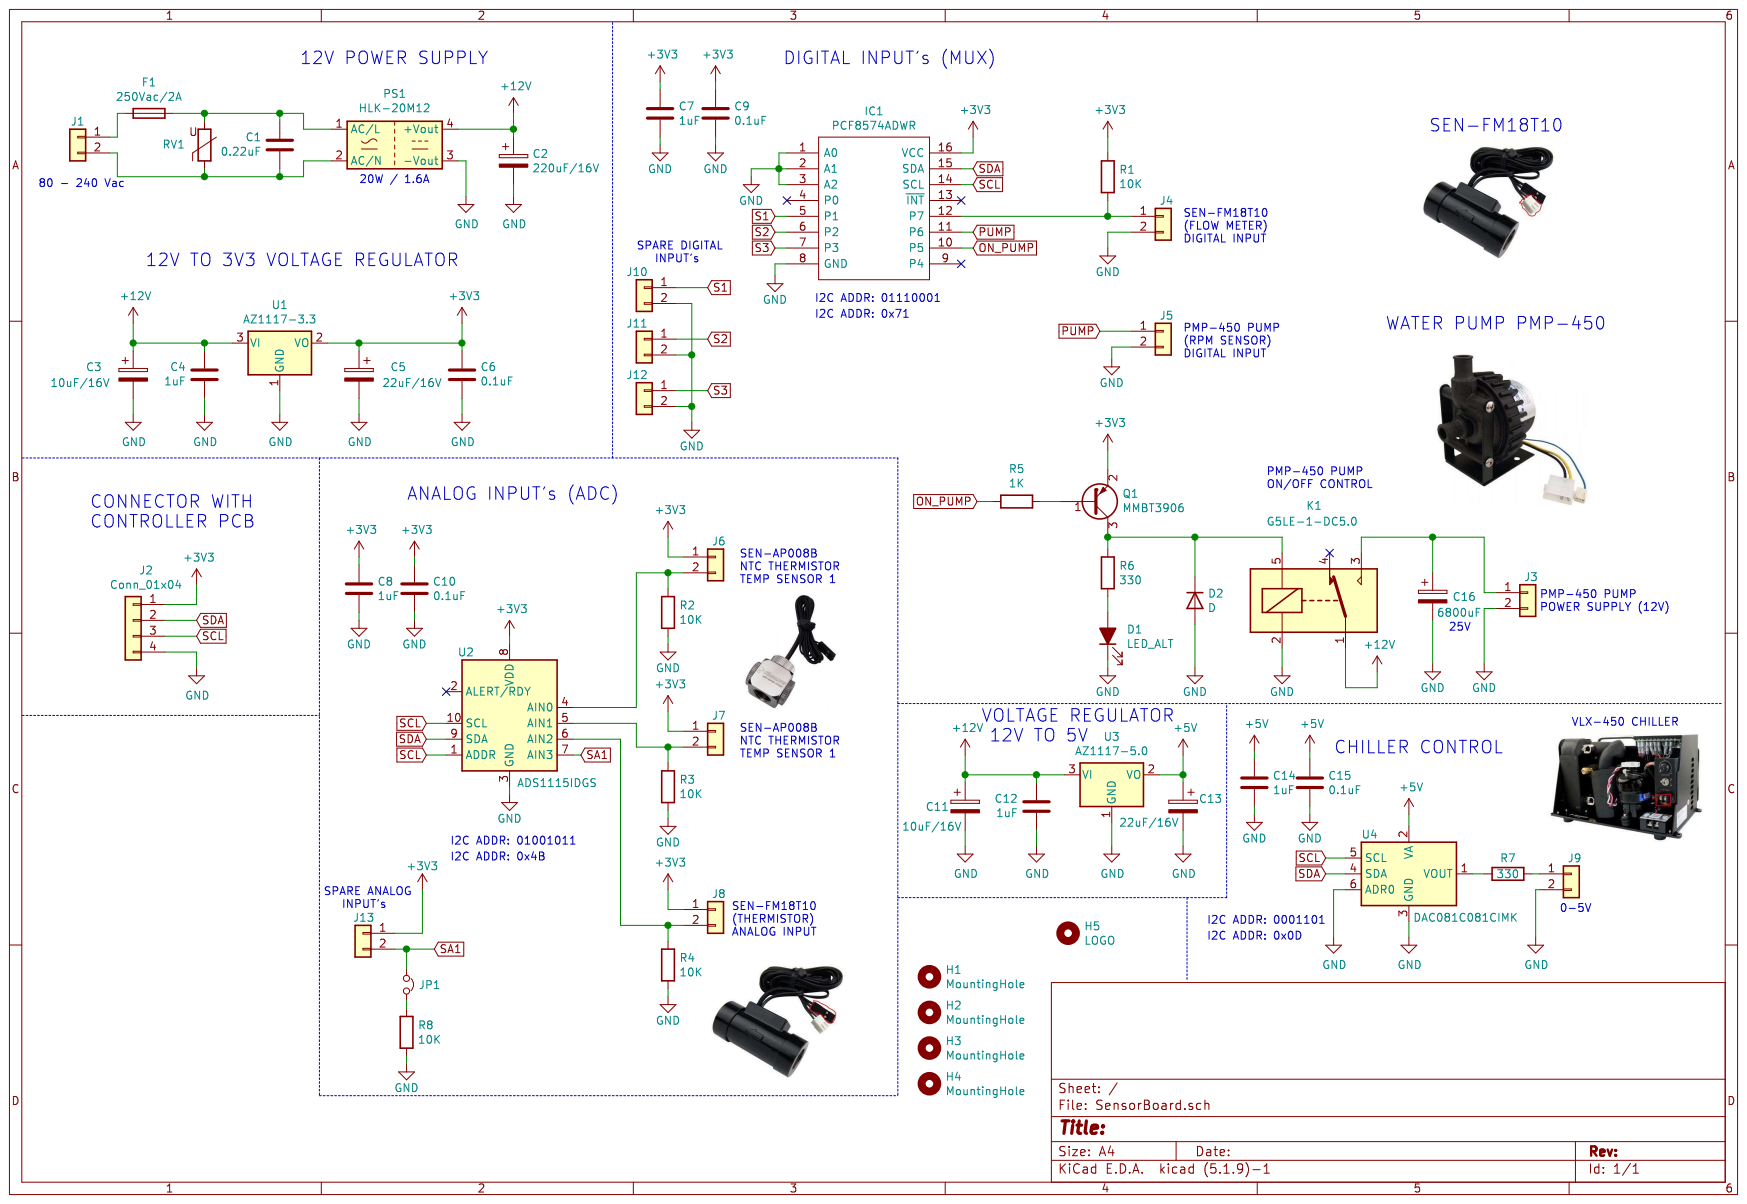
[picture p23: page 1]
