NicolasU-N/PeltierController/Deliverables_ControllerPCB/Deliverables/PCB.pdf

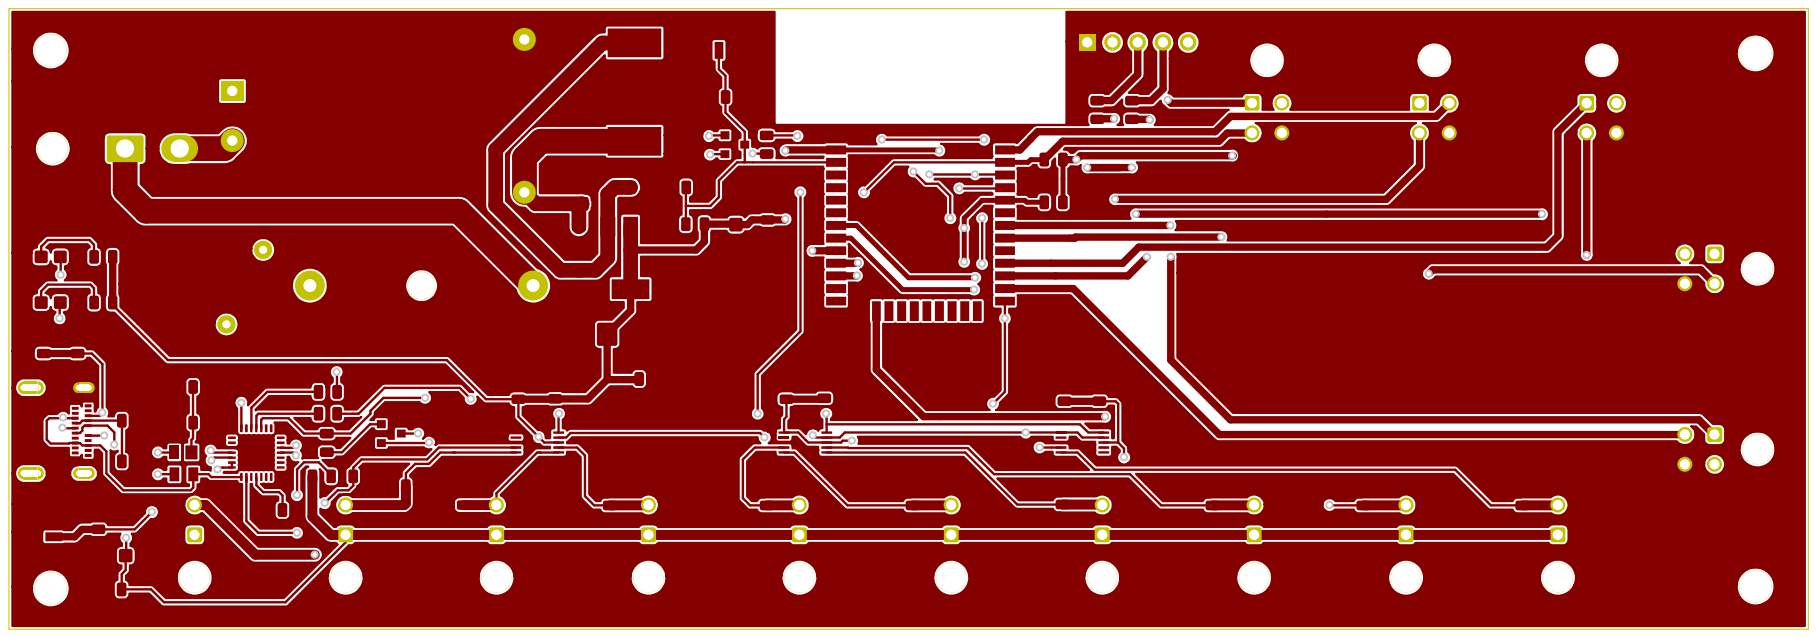
[picture p24: page 1]

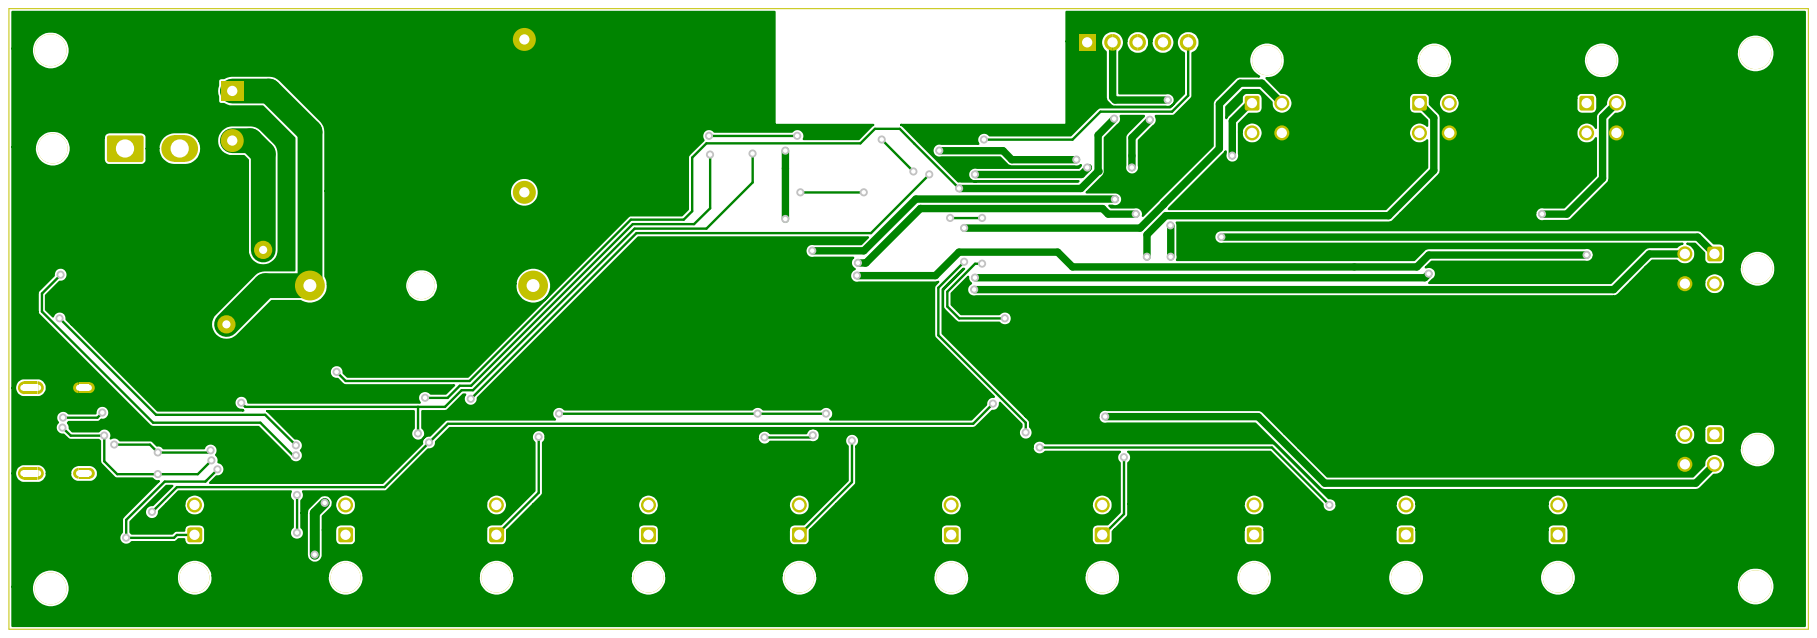
[picture p25: page 2]

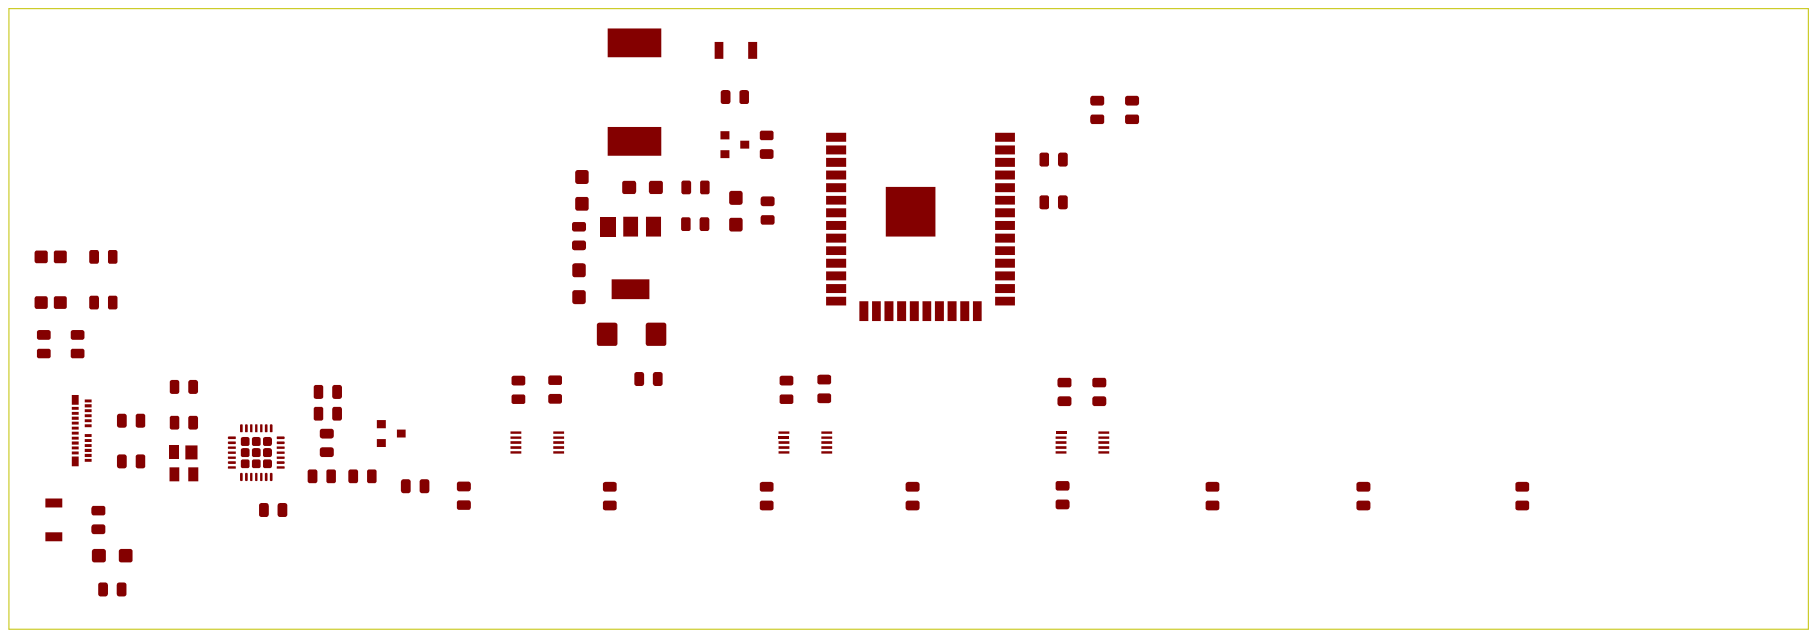
[picture p26: page 5]

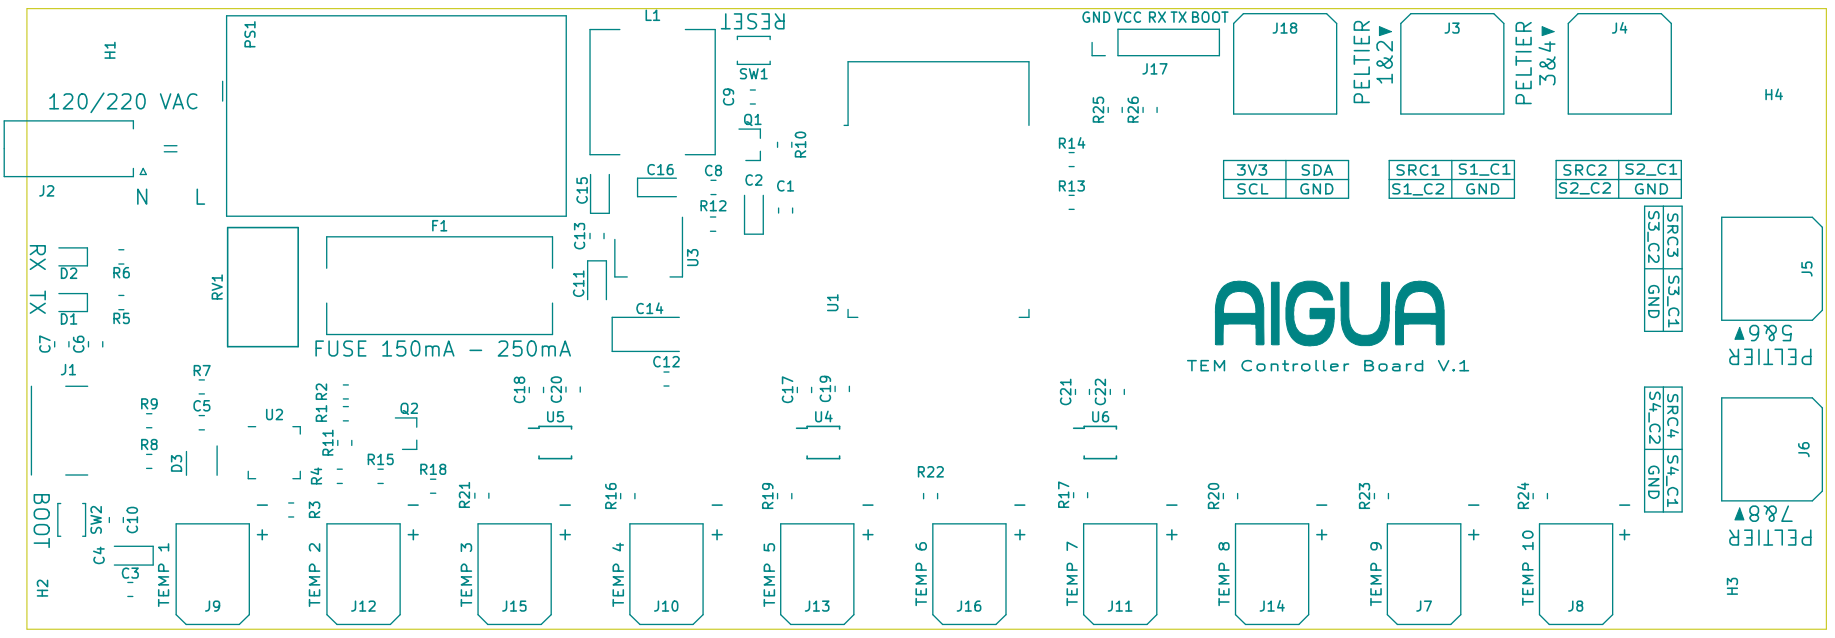
[picture p27: page 7]

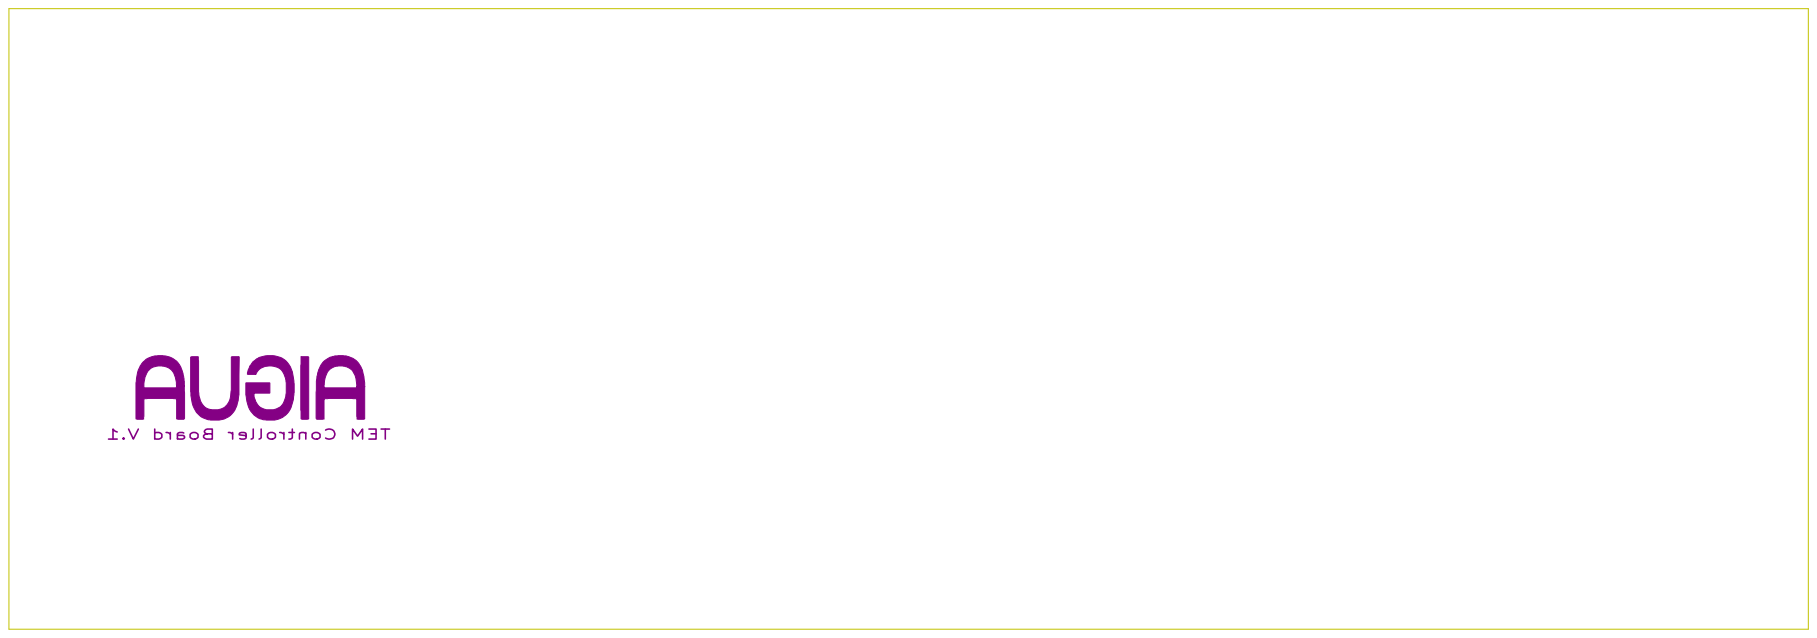
[picture p28: page 8]

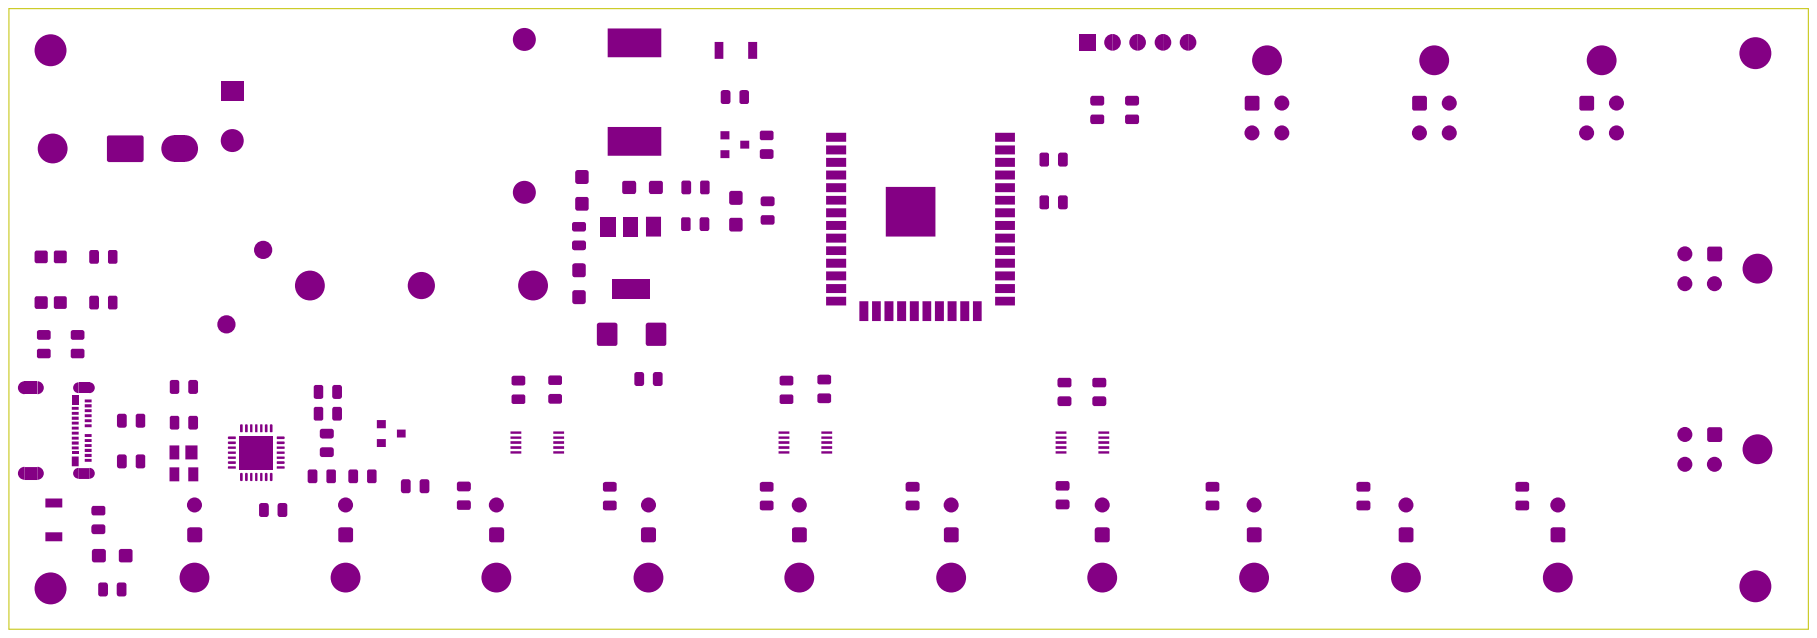
[picture p29: page 9]

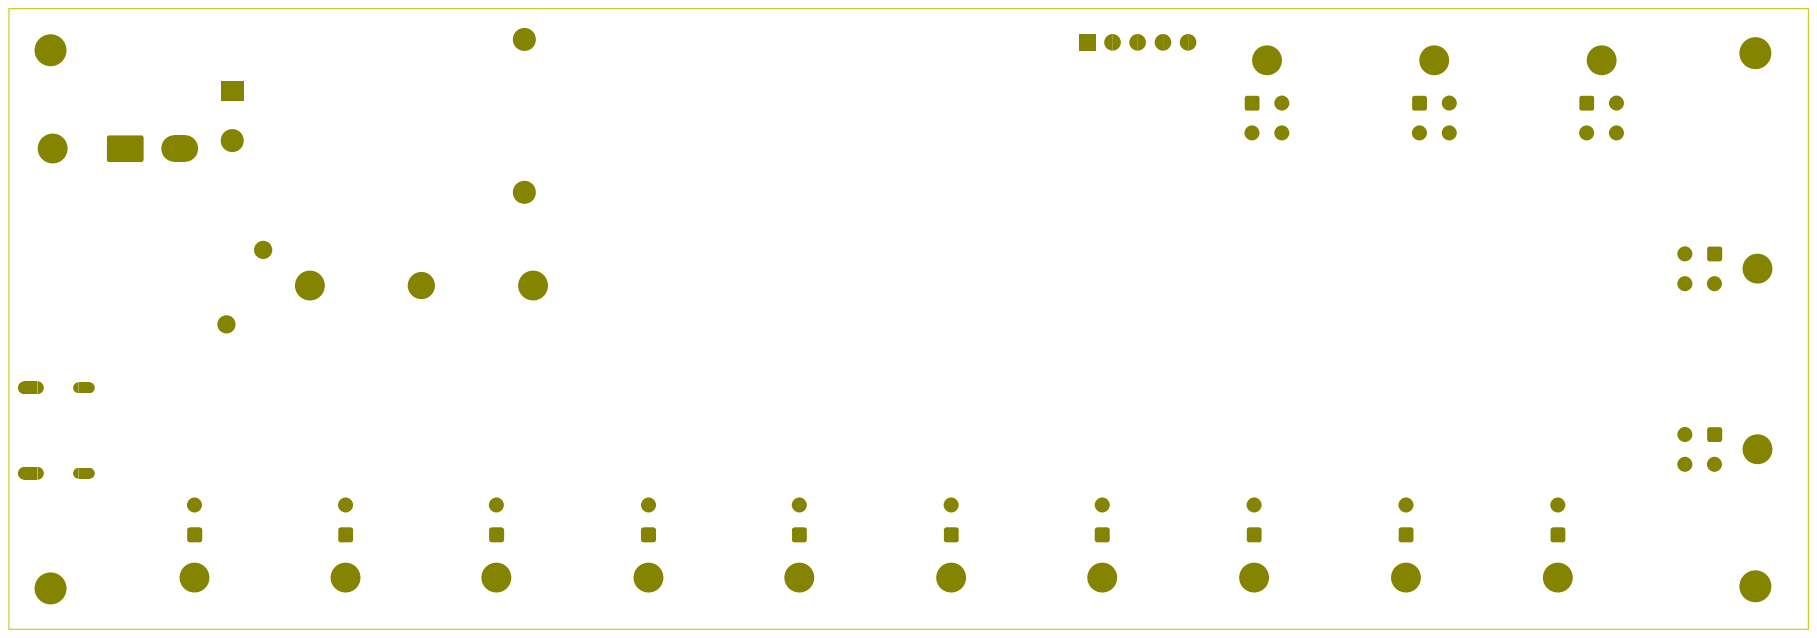
[picture p30: page 10]
