NicolasU-N/PeltierController/Deliverables_PeltierPWMControlPCB/Deliverables/PCB.pdf

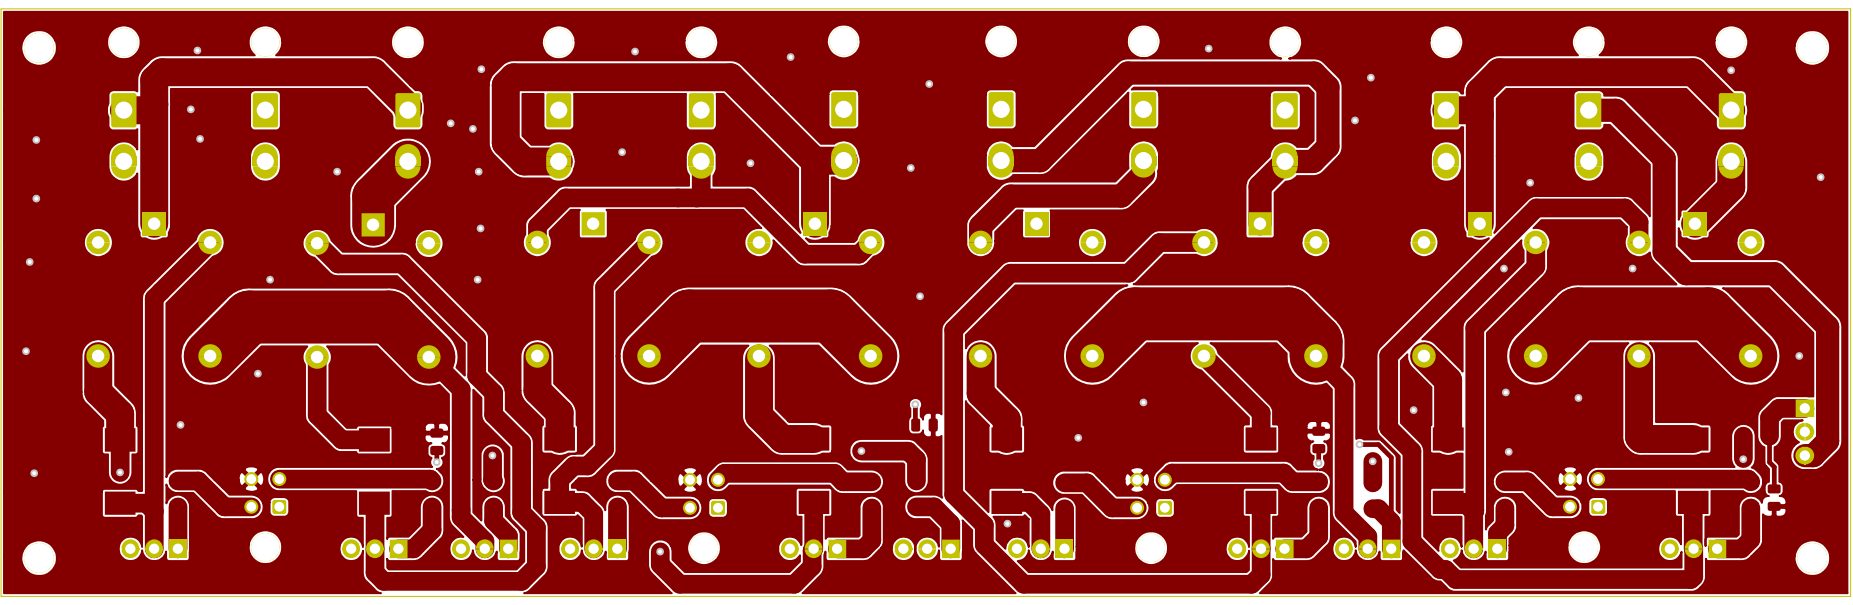
[picture p31: page 1]

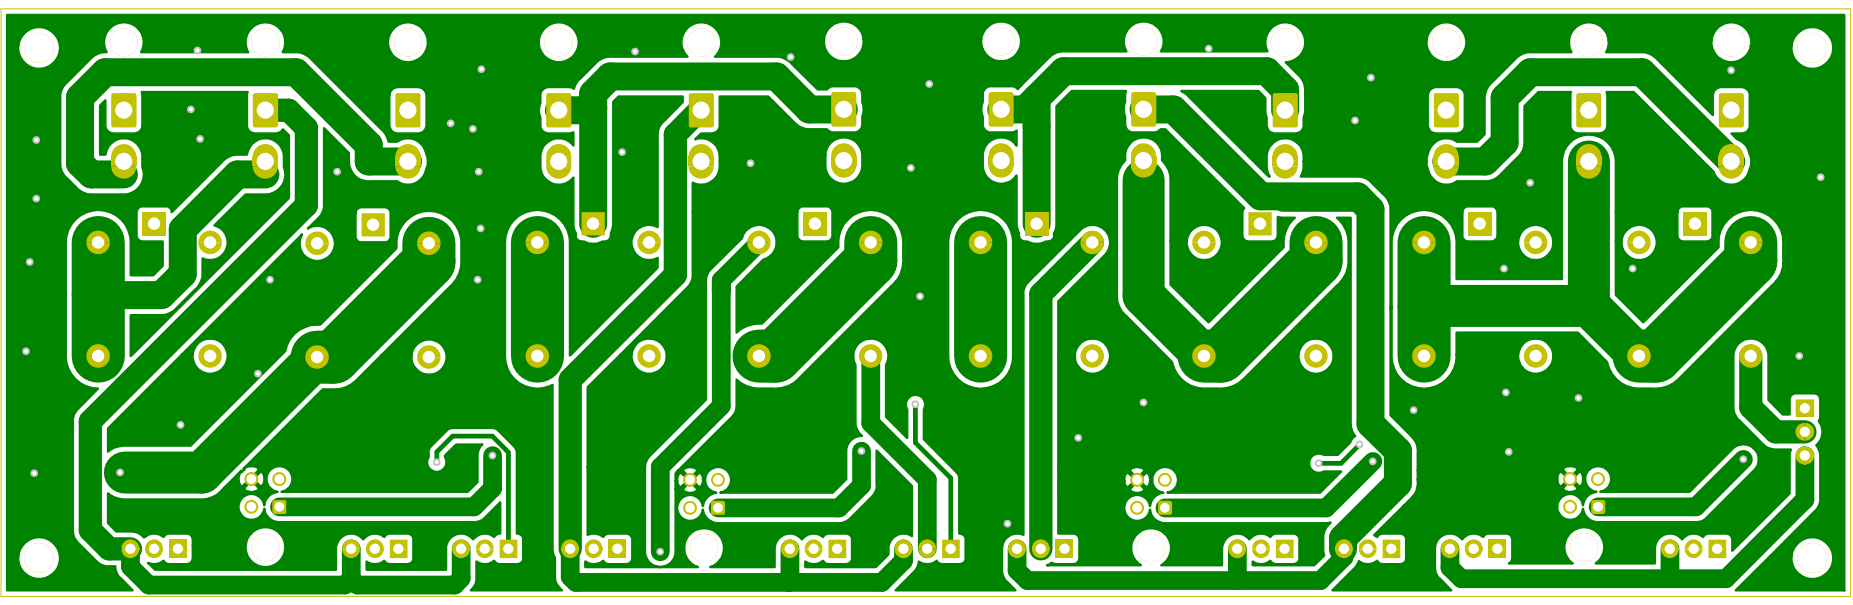
[picture p32: page 2]

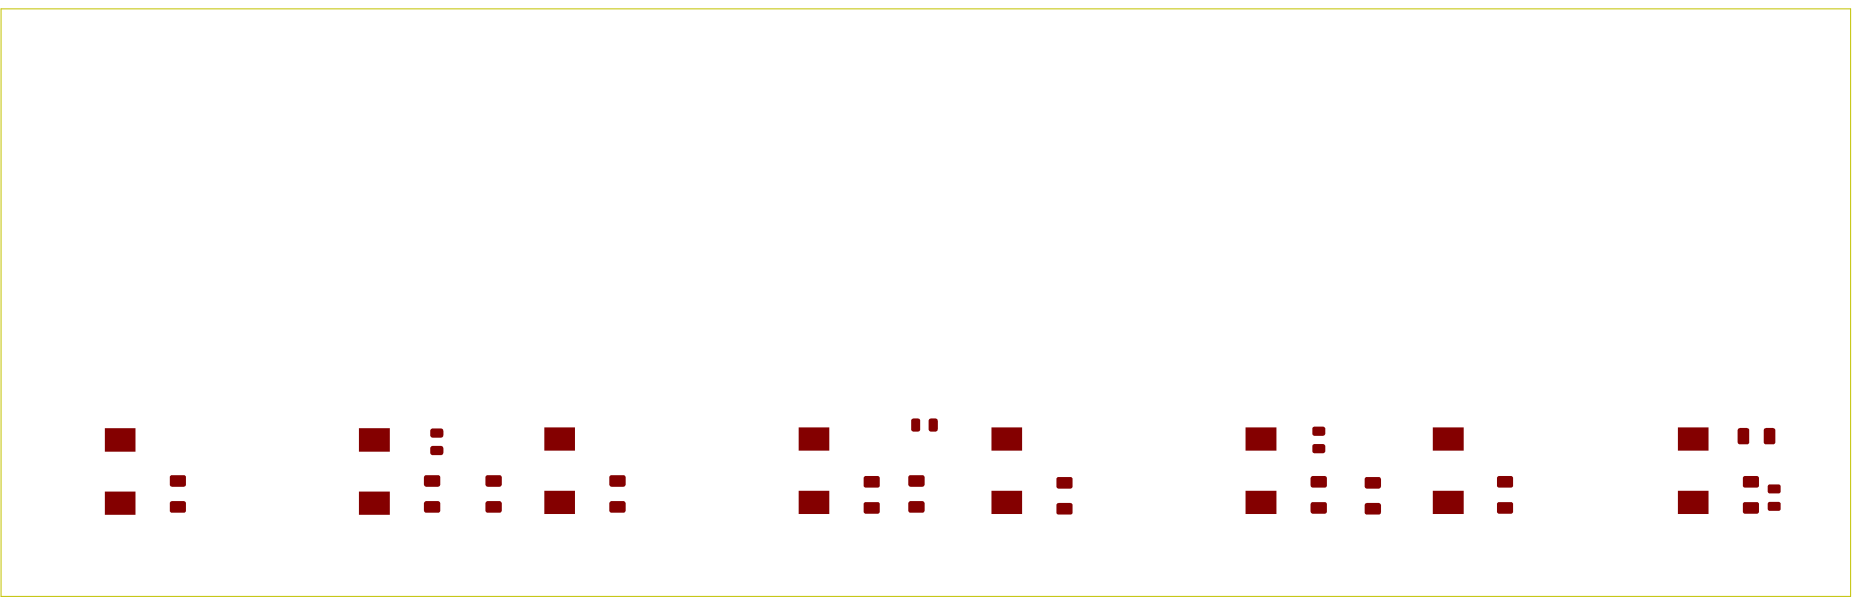
[picture p33: page 5]

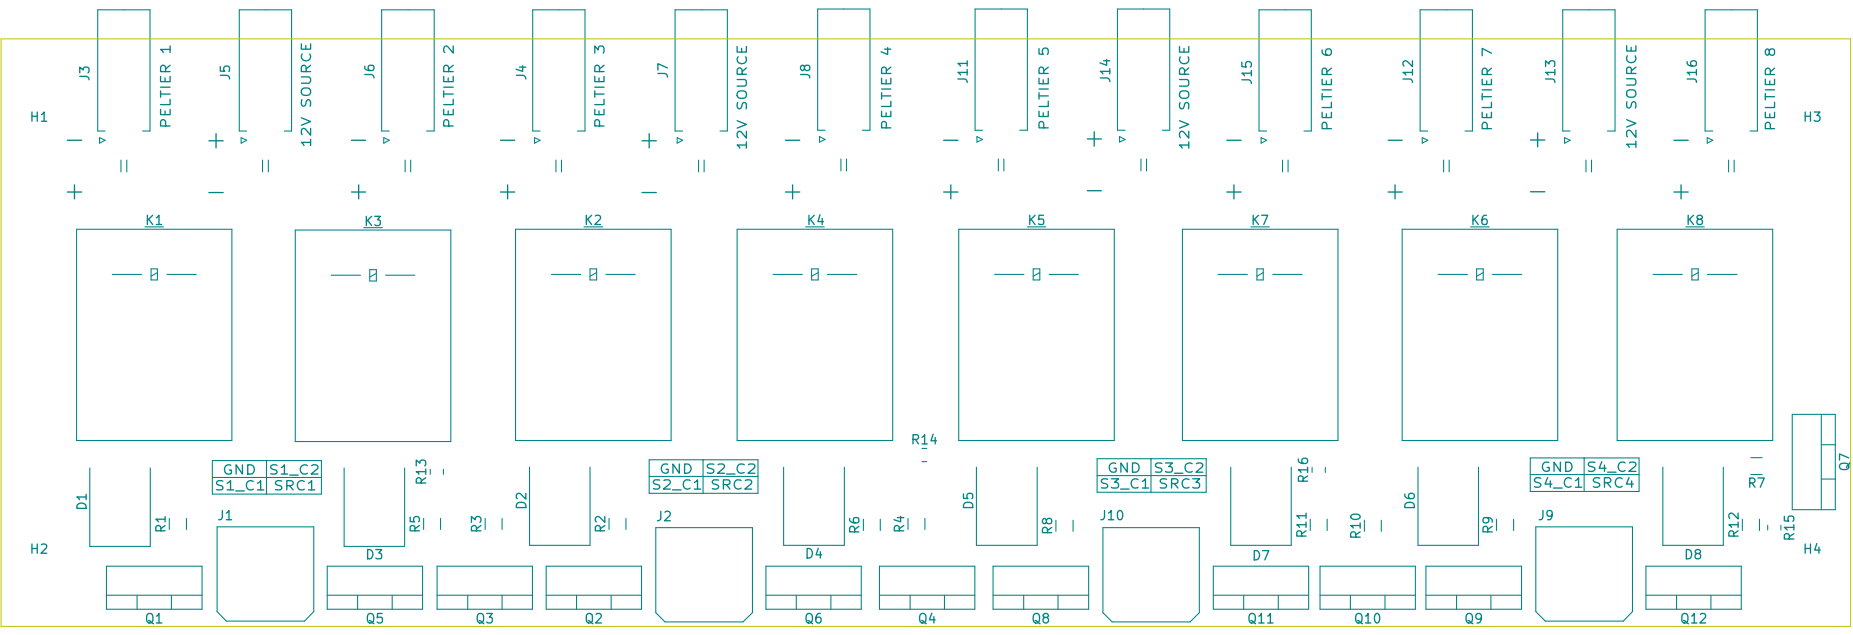
[picture p34: page 7]

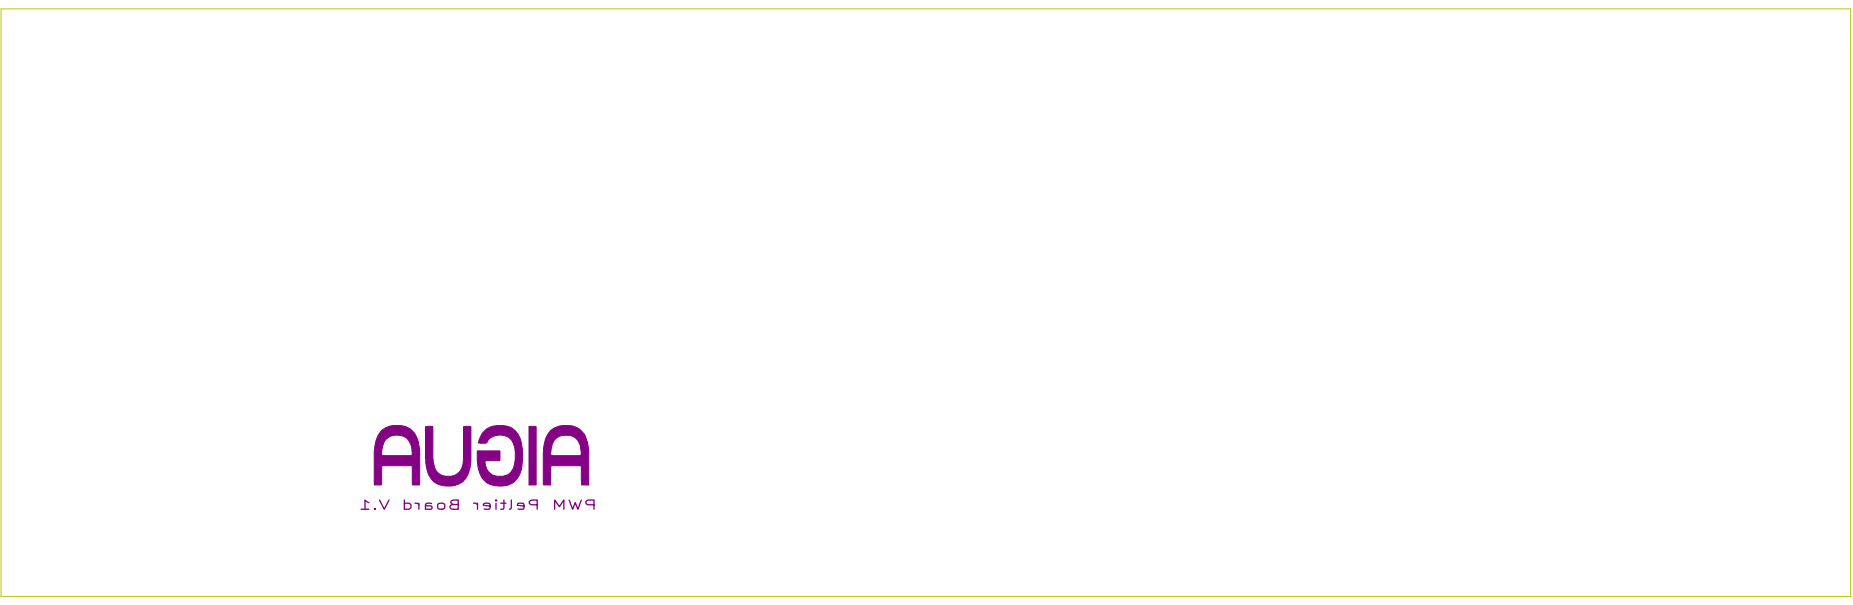
[picture p35: page 8]

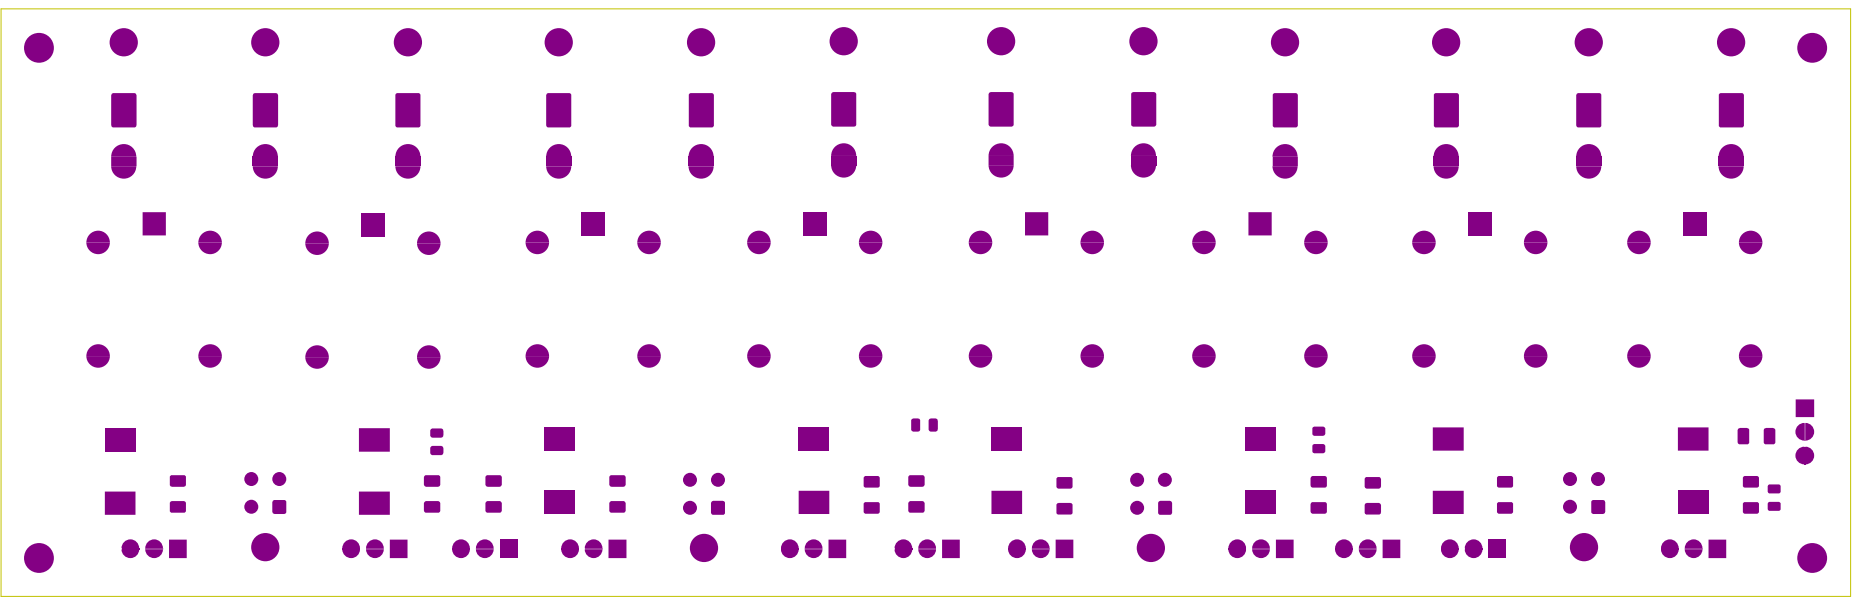
[picture p36: page 9]

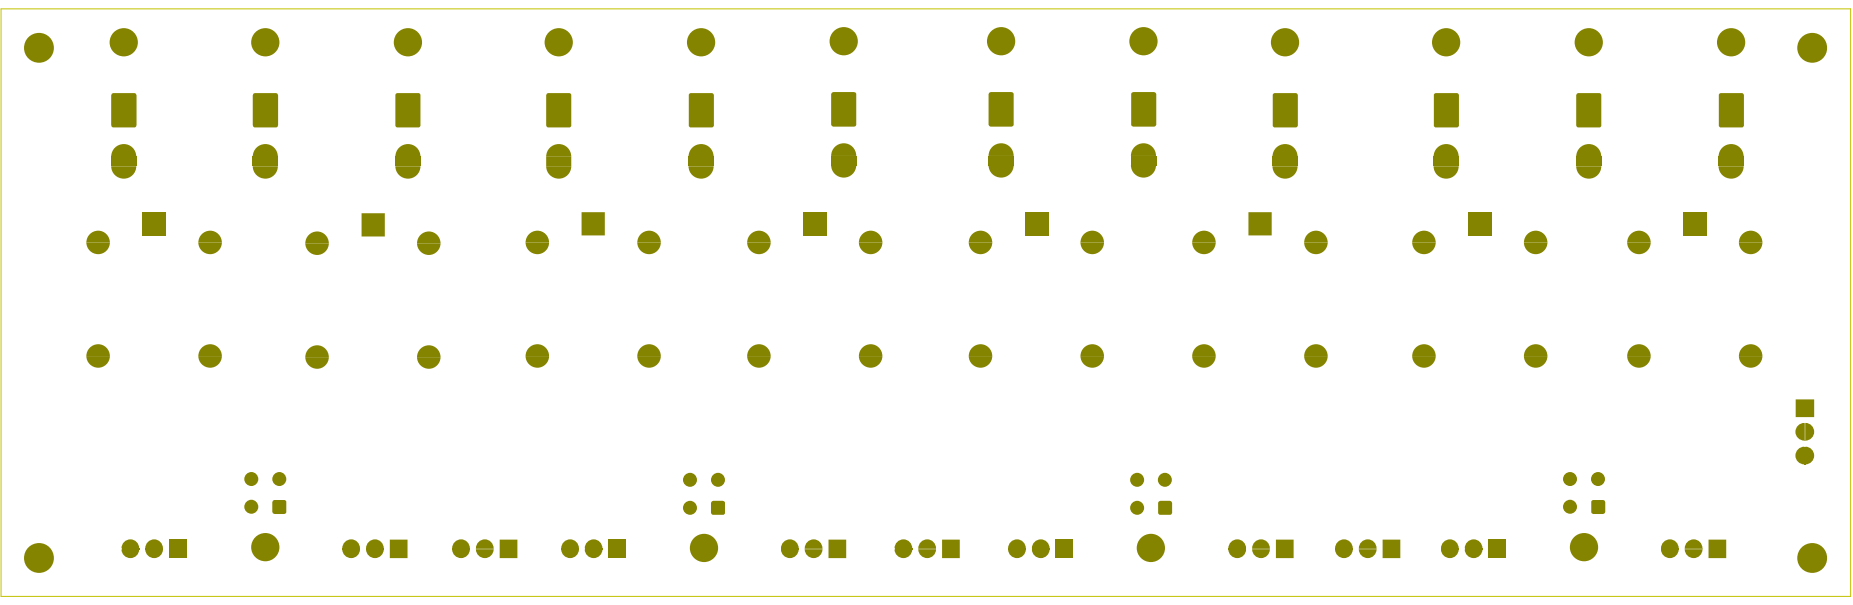
[picture p37: page 10]
