NicolasU-N/PeltierController/Deliverables_SensorPCB/Deliverables/PCB.pdf

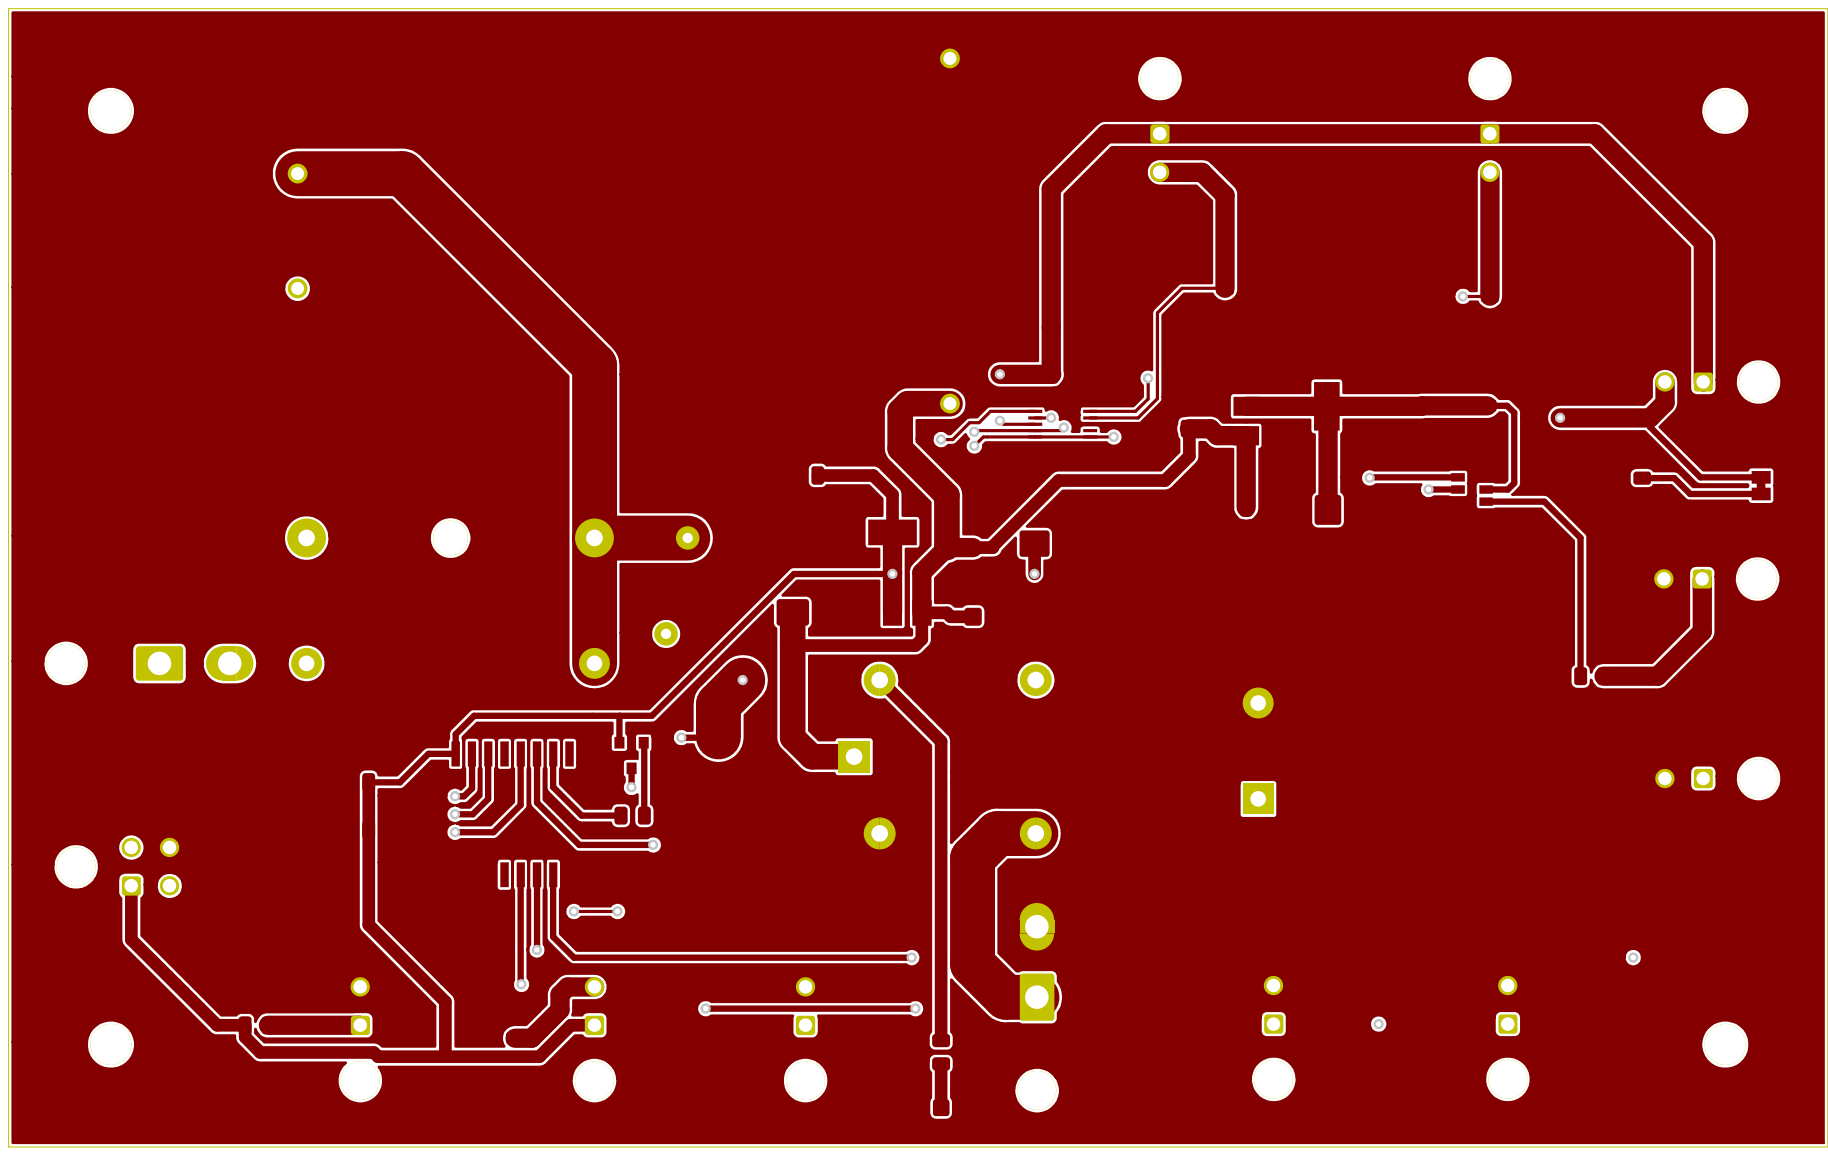
[picture p38: page 1]

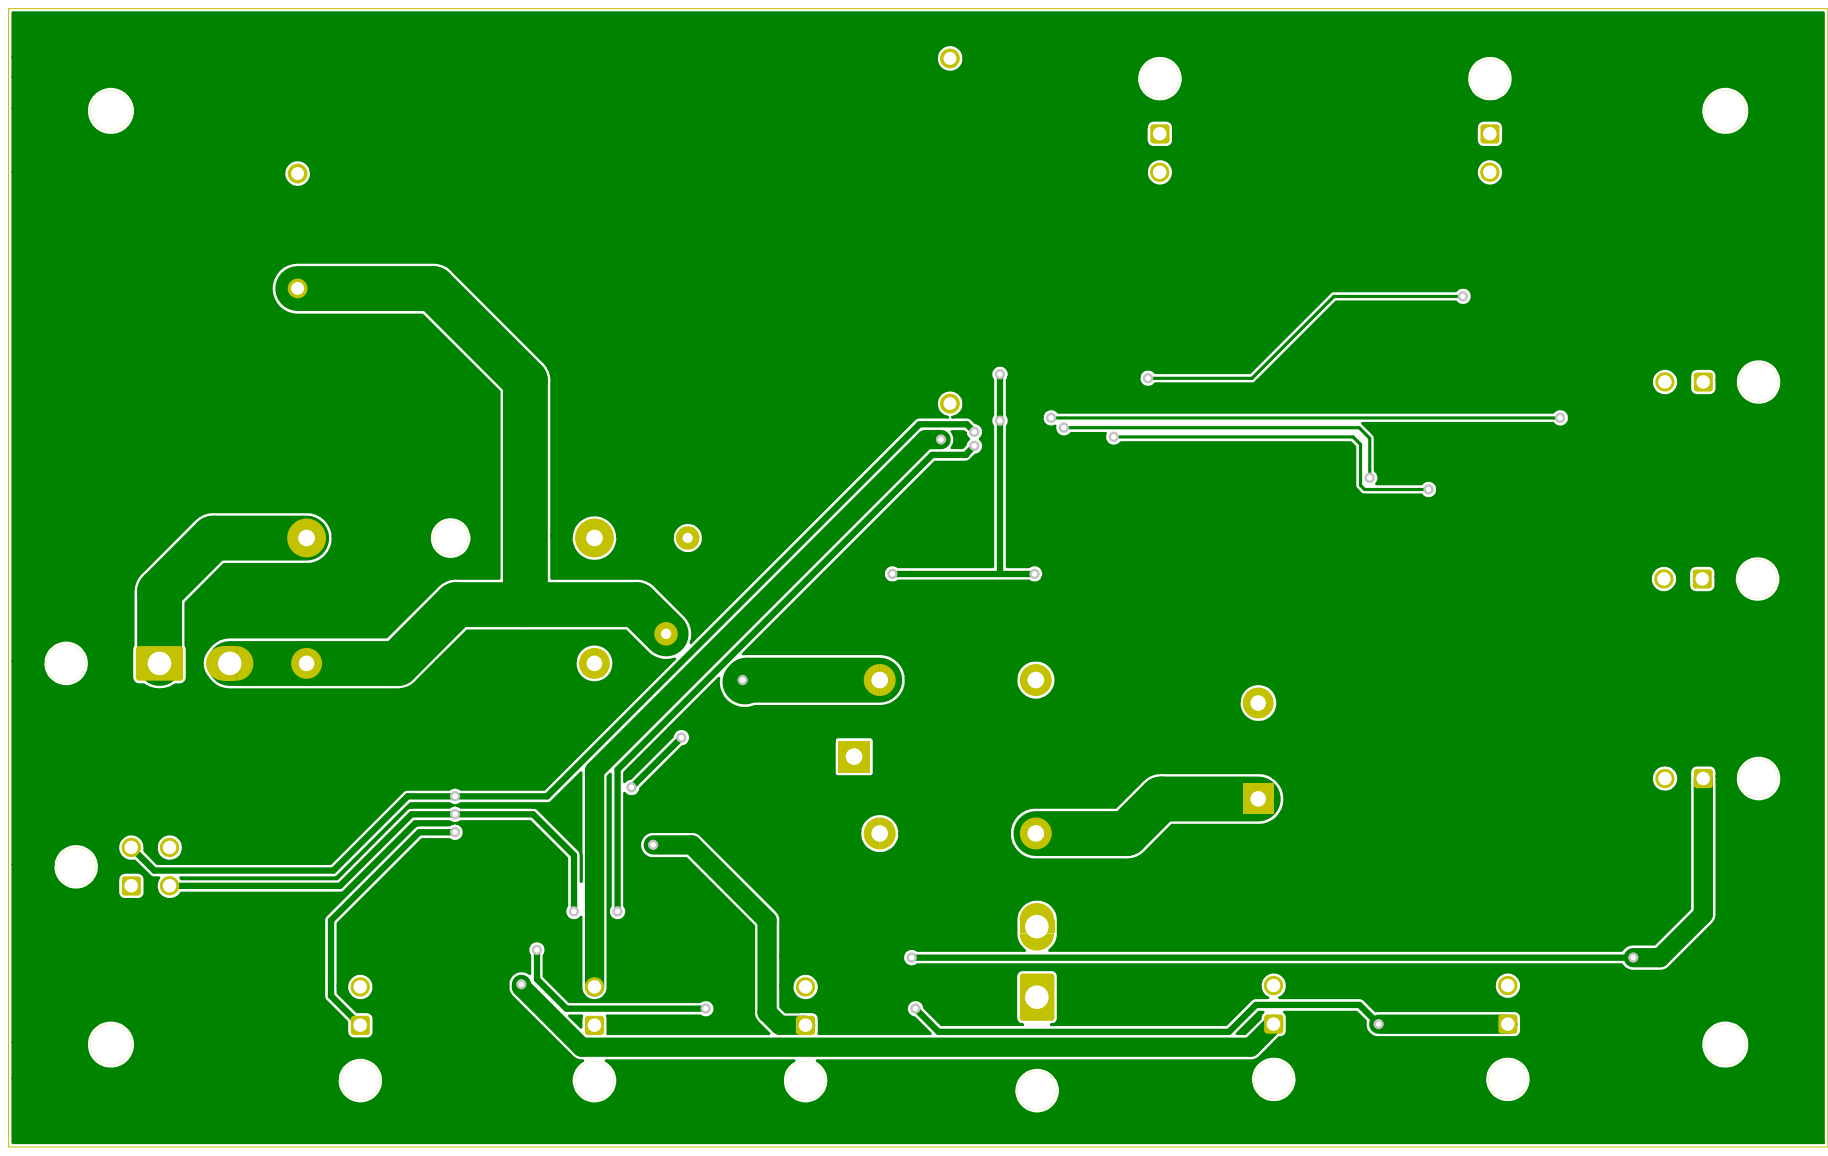
[picture p39: page 2]

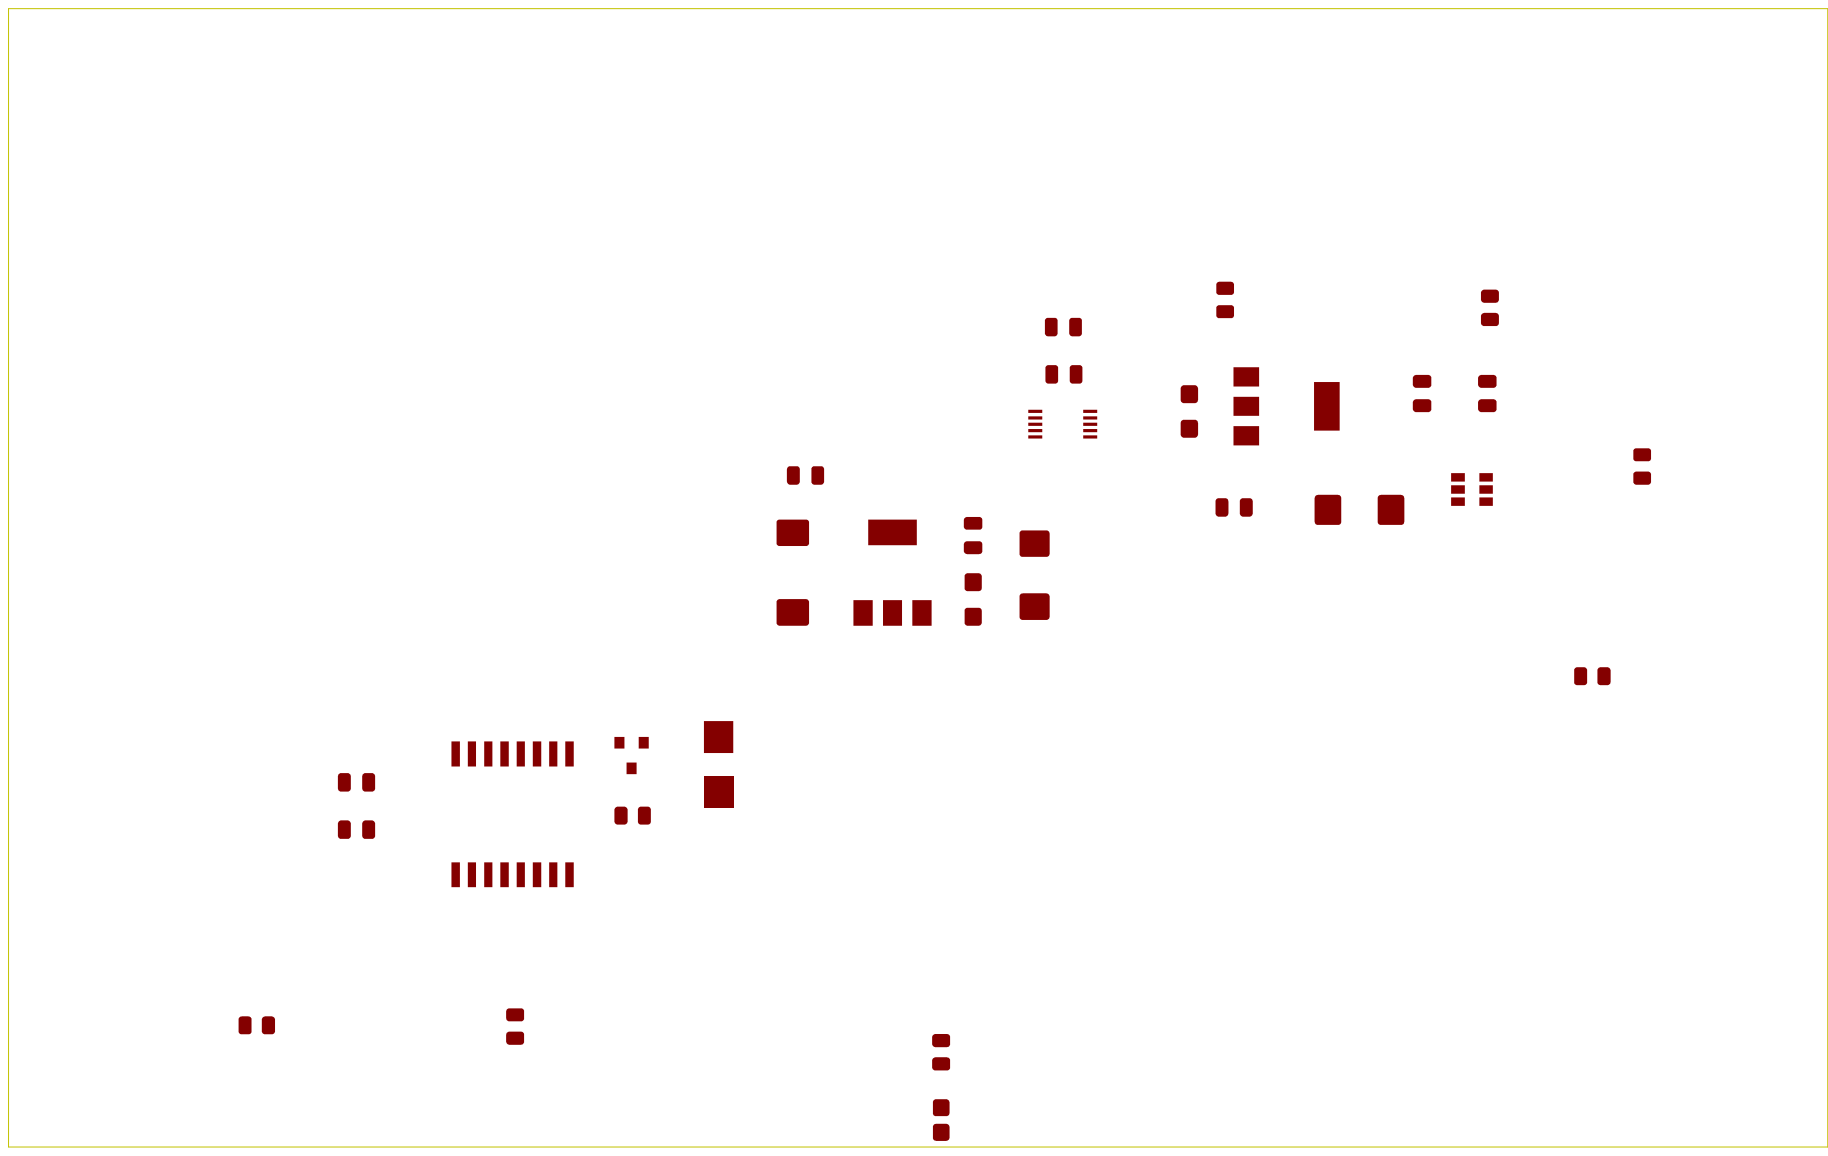
[picture p40: page 5]

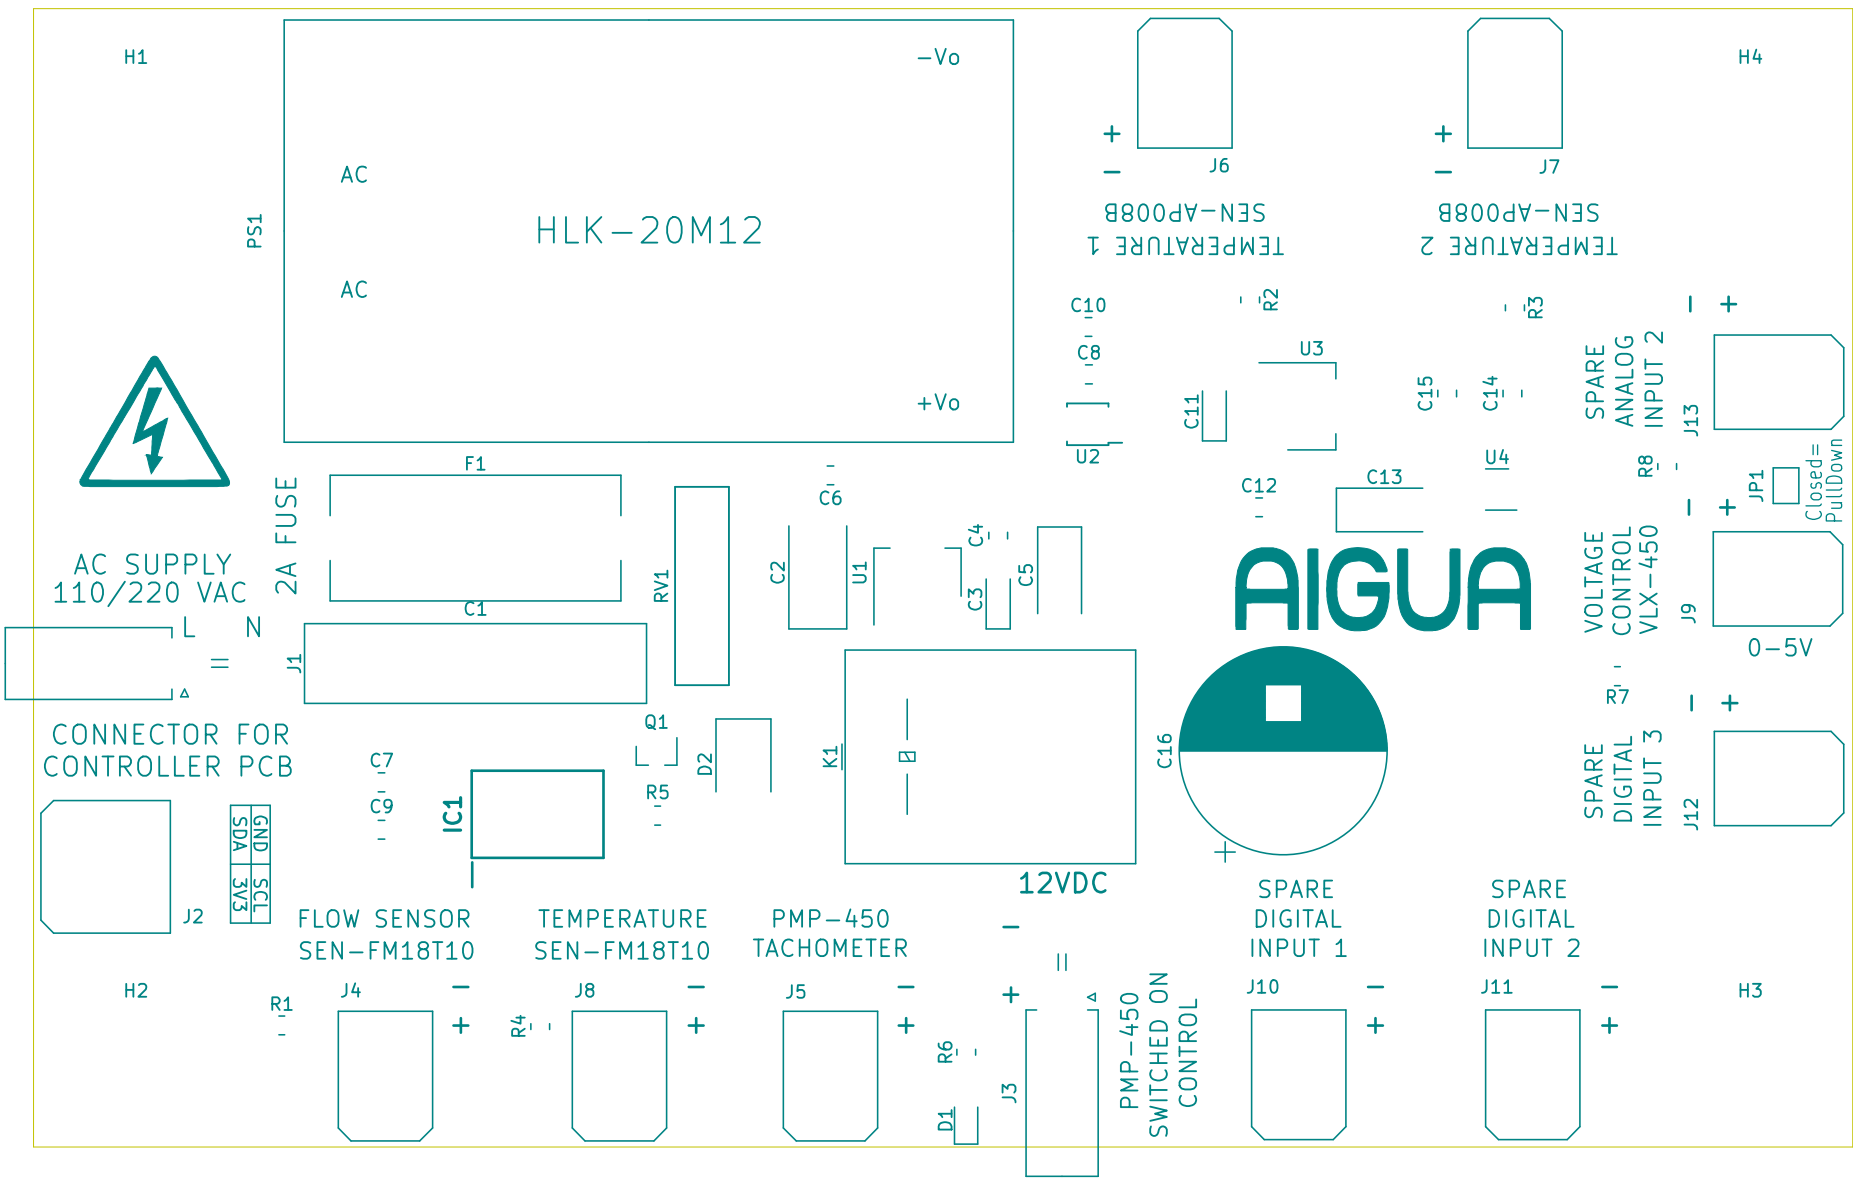
[picture p41: page 7]

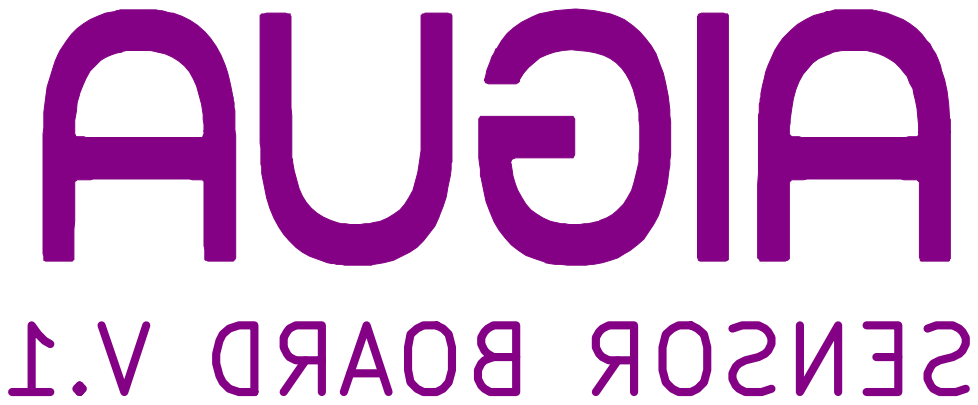
[picture p42: page 8]

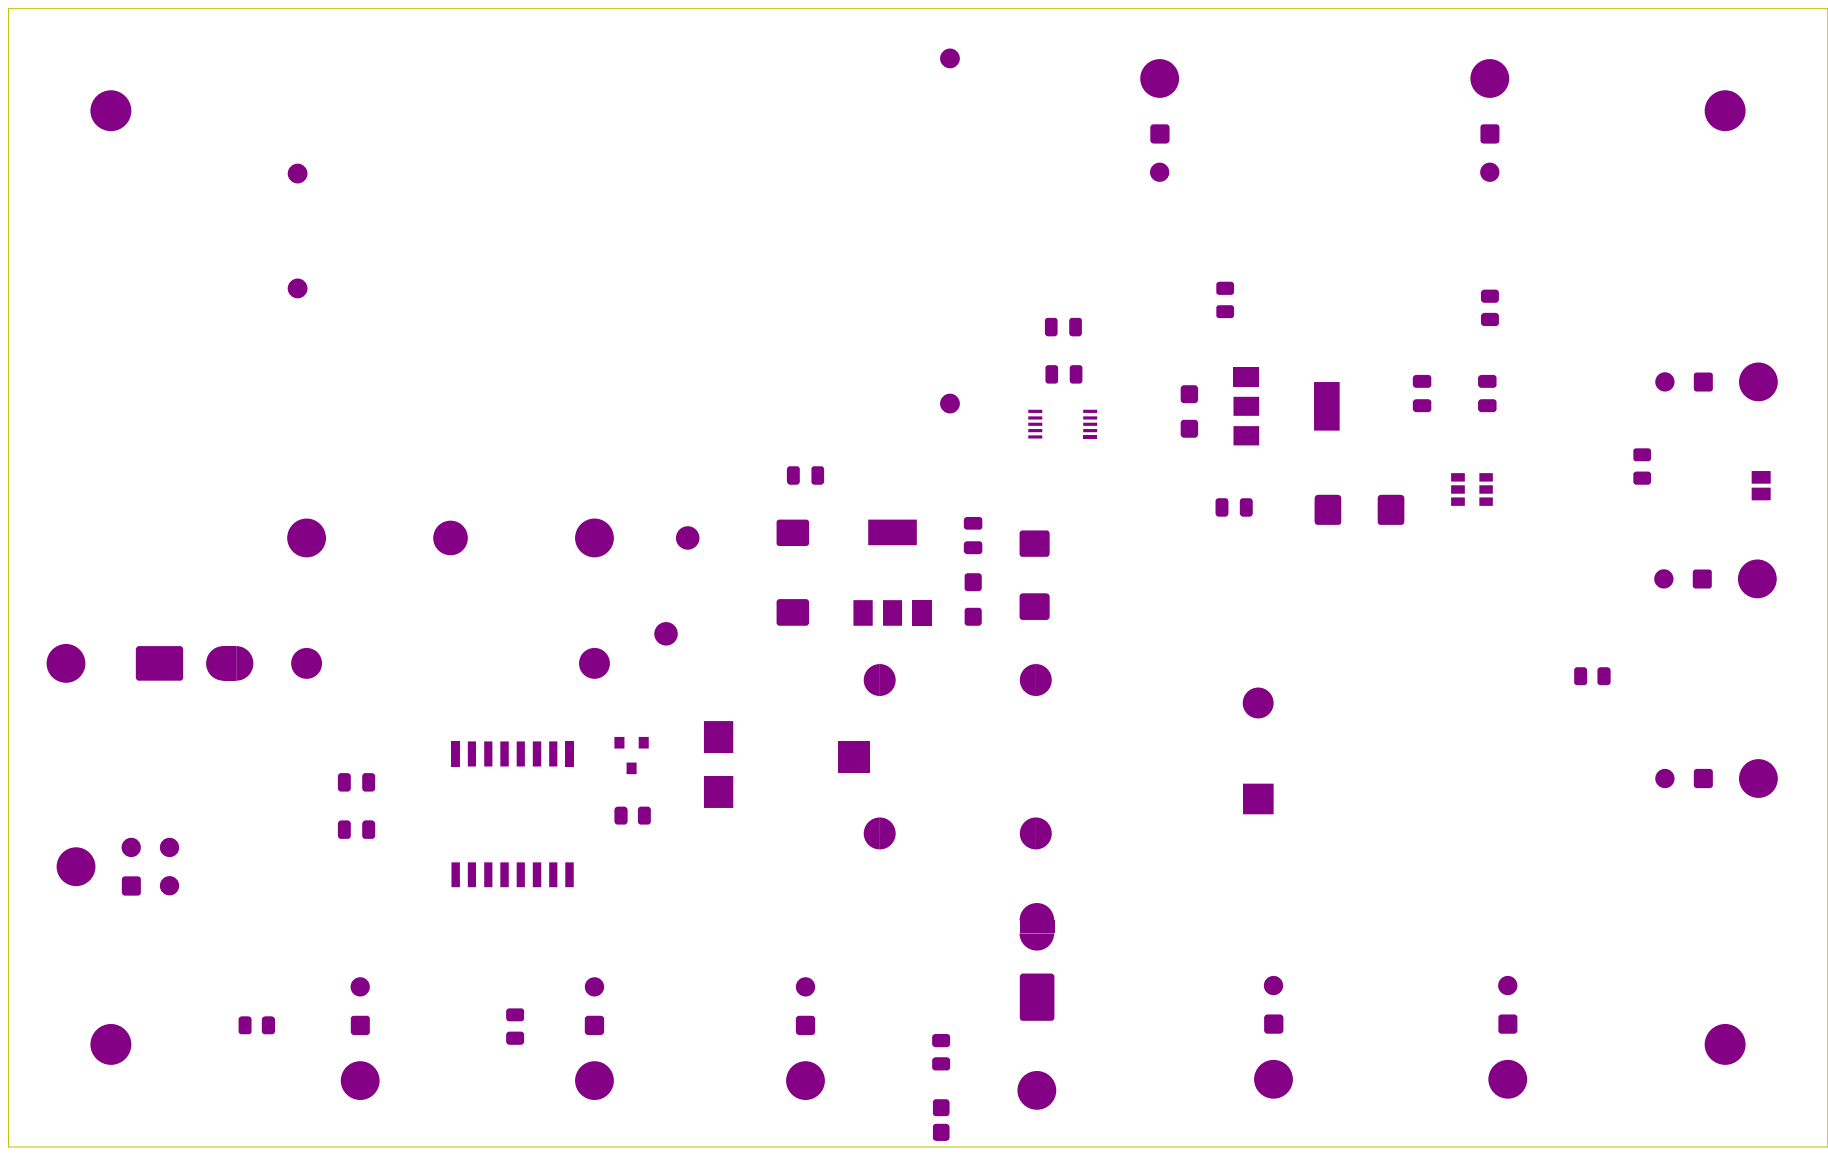
[picture p43: page 9]

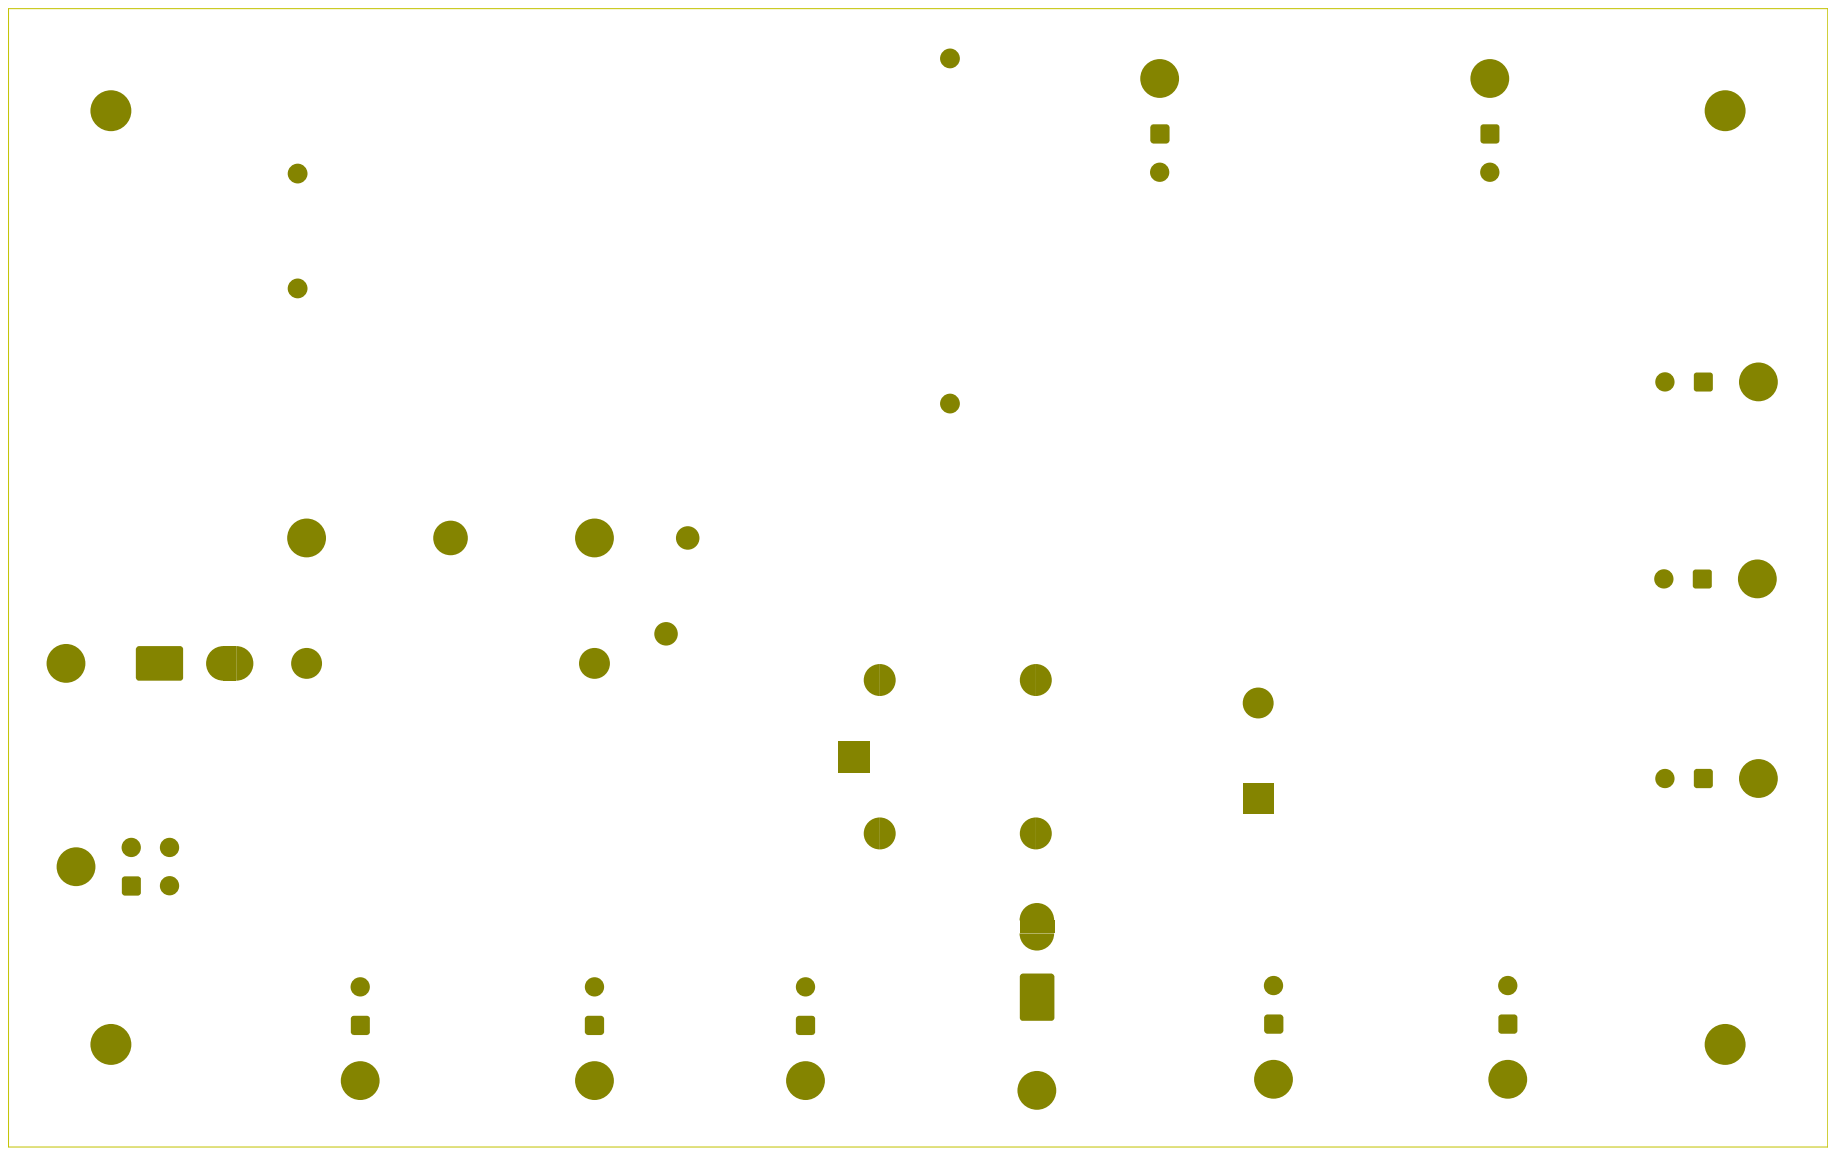
[picture p44: page 10]
