NicolasU-N/PeltierController/Firmware_cooling/Test/TestAdsLite/TestAdsLite.ino

#include<ADS1115_lite.h>

ADS1115_lite ads(ADS1115_ADDRESS_ADDR_GND);  // 0x48 addr pin connected to GND
ADS1115_lite ads1(ADS1115_ADDRESS_ADDR_VDD);  // 0x48 addr pin connected to GND
ADS1115_lite ads2(ADS1115_ADDRESS_ADDR_SDA);  // 0x48 addr pin connected to GND
ADS1115_lite ads3(ADS1115_ADDRESS_ADDR_SCL);  // 0x48 addr pin connected to GND

float tempsPel[10];

float vin = 3260;
float volt = 0;
float R1 = 10500; //10 RES
float R2 = 0;
float buffercon = 0;



void setup() {
  Serial.begin(115200);
  delay(10);
  ads_config_all(); // call to ads_config function
}

void loop() {

  for (uint8_t i = 0; i < 10; i++) {
    tempsPel[i] = readTempPel(i);
  }

  /*
    volt = (float)ads2_read() * 0.125; //voltaje 0.125 -> 1 gain // 0.1875 -> 2/3 gain
    buffercon = (vin / volt) - 1;
    R2 = R1 * buffercon;
    Serial.println(R2);
  */

  delay(500);
}

void ads_config_all() {
  ads.setGain(ADS1115_REG_CONFIG_PGA_4_096V); // GAIN_ONE and resolution to ± 4.096V
  ads.setSampleRate(ADS1115_REG_CONFIG_DR_64SPS); // Set to the fastest MODE 860Samples per sec

  ads1.setGain(ADS1115_REG_CONFIG_PGA_4_096V); // GAIN_ONE and resolution to ± 4.096V
  ads1.setSampleRate(ADS1115_REG_CONFIG_DR_64SPS); // Set to the fastest MODE 860Samples per sec

  ads2.setGain(ADS1115_REG_CONFIG_PGA_4_096V); // GAIN_ONE and resolution to ± 4.096V
  ads2.setSampleRate(ADS1115_REG_CONFIG_DR_64SPS); // Set to the fastest MODE 860Samples per sec

  ads3.setGain(ADS1115_REG_CONFIG_PGA_4_096V); // GAIN_ONE and resolution to ± 4.096V
  ads3.setSampleRate(ADS1115_REG_CONFIG_DR_64SPS); // Set to the fastest MODE 860Samples per sec
}

///////////////////////////////////////////////////////////////////////////////////////////                   ADS 0

int16_t ads_read() {
  ads.setMux(ADS1115_REG_CONFIG_MUX_SINGLE_0);  // Single mode input on AIN0 (AIN0 - GND)
  ads.triggerConversion();  // Triggered mannually
  return ads.getConversion();  // returns int16_t value
}

int16_t ads_read1() {
  ads.setMux(ADS1115_REG_CONFIG_MUX_SINGLE_1);  // Single mode input on AIN0 (AIN0 - GND)
  ads.triggerConversion();  // Triggered mannually
  return ads.getConversion();  // returns int16_t value
}

int16_t ads_read2() {
  ads.setMux(ADS1115_REG_CONFIG_MUX_SINGLE_2);  // Single mode input on AIN0 (AIN0 - GND)
  ads.triggerConversion();  // Triggered mannually
  return ads.getConversion();  // returns int16_t value
}

int16_t ads_read3() {
  ads.setMux(ADS1115_REG_CONFIG_MUX_SINGLE_3);  // Single mode input on AIN0 (AIN0 - GND)
  ads.triggerConversion();  // Triggered mannually
  return ads.getConversion();  // returns int16_t value
}


///////////////////////////////////////////////////////////////////////////////////////////                   ADS 1

int16_t ads1_read() {
  ads1.setMux(ADS1115_REG_CONFIG_MUX_SINGLE_0);  // Single mode input on AIN0 (AIN0 - GND)
  ads1.triggerConversion();  // Triggered mannually
  return ads1.getConversion();  // returns int16_t value
}

int16_t ads1_read1() {
  ads1.setMux(ADS1115_REG_CONFIG_MUX_SINGLE_1);  // Single mode input on AIN0 (AIN0 - GND)
  ads1.triggerConversion();  // Triggered mannually
  return ads1.getConversion();  // returns int16_t value
}

int16_t ads1_read2() {
  ads1.setMux(ADS1115_REG_CONFIG_MUX_SINGLE_2);  // Single mode input on AIN0 (AIN0 - GND)
  ads1.triggerConversion();  // Triggered mannually
  return ads1.getConversion();  // returns int16_t value
}

int16_t ads1_read3() {
  ads1.setMux(ADS1115_REG_CONFIG_MUX_SINGLE_3);  // Single mode input on AIN0 (AIN0 - GND)
  ads1.triggerConversion();  // Triggered mannually
  return ads1.getConversion();  // returns int16_t value
}

///////////////////////////////////////////////////////////////////////////////////////////                  ADS 2

int16_t ads2_read() {
  ads2.setMux(ADS1115_REG_CONFIG_MUX_SINGLE_0);  // Single mode input on AIN0 (AIN0 - GND)
  ads2.triggerConversion();  // Triggered mannually
  return ads2.getConversion();  // returns int16_t value
}

int16_t ads2_read1() {
  ads2.setMux(ADS1115_REG_CONFIG_MUX_SINGLE_1);  // Single mode input on AIN0 (AIN0 - GND)
  ads2.triggerConversion();  // Triggered mannually
  return ads2.getConversion();  // returns int16_t value
}

int16_t ads2_read2() {
  ads2.setMux(ADS1115_REG_CONFIG_MUX_SINGLE_2);  // Single mode input on AIN0 (AIN0 - GND)
  ads2.triggerConversion();  // Triggered mannually
  return ads2.getConversion();  // returns int16_t value
}

int16_t ads2_read3() {
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



  //float Temp_C = Temp_K - 273.15; //converting into Celsius
  return vout;//Temp_C;

  //Serial.println("");
}


float getOhms(int16_t lecture) {
  volt = abs(lecture) * 0.125; //0.125->1 gain
  buffercon = (vin / volt) - 1;
  return R1 * buffercon;

}


float getRes5kTemperature(int16_t res)
{
  float tx = 530.1959 * pow((float)res, -0.1231) - 160.7144;
  return tx;
}

float getRes10kTemperature(int16_t res)
{
  float tx = 708.9896 * pow((float)res, -0.1471) - 157.9437;
  return tx;
}
