NicolasU-N/PeltierController/(commit log)

2021-02-23 Add methods sensors
2021-05-28 Fix temps TODO: pcf dir
    [CodePeltiersV3.ino, Encoder_Buffer_Linear_actuator_I2Cv3.ino, test_pcf8574.ino]
2021-08-02 Writing version with new ads library, adding rising edge function pcf8574 and task in parallel to write to dac081c
    [TETECH-TS_curves.xlsx, koolance_sen-ap008g_Values.xlsx]
2021-10-14 Fix Test Reles TODO: review FirmwareControllerSensor
    [CodePeltiers_test_reles_peltier.ino, FirmwareControllerSensor.ino]
